taimecha/da_robot_kho_hang/memory-bank/progress.md

# Progress

## 2026-10-24 — rà soát điều phối ba xe

- Chạy mới `demo30` với ba Nav2, xe động học giả, camera/LiDAR tổng hợp và hàng
  chờ cột: 30/30 kiện, 0 lỗi audit, khoảng cách tâm nhỏ nhất 0,589657 m;
  kiện cuối 715,751 s, cả ba đỗ xong 736,402 s.
- Kiểm tra độc lập 9.600 trường hợp lưới trống: đường ngắn nhất và ít lần đổi
  hướng nhất trong các đường ngắn. Toàn bộ 164 test đạt. Báo cáo và log ở
  `docs/warehouse_route_audit_20261024/`.
- `tools/warehouse_report.py` ghi thêm quãng đường và tổng góc xoay odometry.
  Chưa khẳng định tối ưu toàn cục khi xe tranh chấp, hoặc kết quả xe thật.

## Đã xong (mới nhất trước)
| Ngày | Việc | Commit |
|---|---|---|
| 2026-10-16 | RViz hai xe: sửa xacro và launch để AGV1 thân/bánh xanh, AGV2 thân/bánh cam, trùng màu marker, footprint và hạt AMCL; chỉ đổi màu hiển thị, có hiệu lực khi khởi động lại robot_state_publisher | commit này |
| 2026-10-16 | Chuẩn bị 6 video NCKH liên tiếp: đặt xe và định vị một lần, điều hướng tự chuyển sang vị trí đầu từng clip, terminal lệnh và bag riêng cho mỗi clip trong `docs/KICH_BAN_VIDEO_NCKH.md`; đã dọn ROS/điều phối cũ khi xe tắt điện. Giao diện đo báo giao hàng thành công từng xe, giữ 10 giây và phát `delivered` | commit này |
| 2026-10-16 | Hai xe thật: lọc nhiễu LiDAR, hiệu chuẩn lại hai camera, chốt trung bình 5 ảnh; hộp xanh 23,9 cm vào ô (1,1) với nút xanh; xe 1 đạt góc 0,39° và lệch tâm 1,7 cm; điều phối `--no-stdin`, giao diện tự đóng sau khi cả hai xe giao xong. 39 unit tests đạt | HEAD |
| 2026-10-15 | **Đo hàng thật đạt, 2 xe trọn vòng**: GrabCut gieo từ LiDAR, camera yaw/pitch (`tools/cam_extrinsic.py --height`), cao tính tới sàn, giao lại khi bị chặn, firmware tự restart khi tạo entity lỗi; 18,5×32,0→18,7×32,0, 12,0×23,9→13,0×24,1 | 33c4443 |
| 2026-10-14 | ESP32-CAM dùng firmware stream sẵn (`cameras.agvN.url`), ảnh khác cỡ hiệu chuẩn → phóng lên; **sửa DDS**: WSL rơi gói UDP > 1472 B trên loopback → `tools/fastdds_localhost.xml` (gói 1400) | (HEAD) |
| 2026-10-13 | **Camera thật (code)**: `firmware/esp32_cam`, `tools/esp32_cam_node.py`, `tools/cam_calib.py`, camera riêng từng xe; lấy hàng cột 5 (quay Đông) → trả hàng 1; `fleet_real.sh` bật camera. Chưa thử phần cứng | (HEAD) |
| 2026-10-12 | **Đo hàng bằng camera (mô phỏng)**: `cargo_measure.py`, `cargo_task.py`, `tools/sim_cargo.py`, `cargo.yaml`; 9 lần đo sai ≤ 3,5 mm, hai xe chung ô đích, hàng quá khổ báo lỗi | (HEAD) |
| 2026-10-10 | Local costmap hết ô "kẹt" (vật cản còn trên RViz dù LiDAR không thấy): ObstacleLayer + `observation_persistence 1.0` + `fleet_agent` xoá lớp vật cản mỗi 1 s (`clear_except`, giữ 0.5 m); `raytrace_max_range 10` | (HEAD) |
| 2026-10-10 | **Hai xe thật chạy đủ 6 bước** theo logic mô phỏng, không va. Sửa: dây động cơ riêng từng xe, firmware tách `Xe_1`/`Xe_2`, ESTOP báo ngay về máy tính, URDF base_footprint tại trục bánh, xe không xoay vòng khi đích là ô đang đứng / chạy nốt khi Nav2 dừng sớm, `tools/fleet_localize.py` (ICP), `tools/wheel_test.py` | 7b1c103..(HEAD) |
| 2026-10-10 | Hai xe thật: hiệu chỉnh riêng từng xe (`WHEEL_R_agvN`, `COAST_agvN`), `fastdds shm clean` khi up/down; Kịch bản 4 có 6 bước thử lần đầu — chạy đủ 6 bước trên 2 ESP32 giả: tới đích, không va (lệch hướng 6–9° do AMCL giả thô) | a4af8ee |
| 2026-10-10 | **Môi trường vận hành tự động**: `tools/agvctl` (up/down/status/errors/events/logs/goal/stop/localize/serial/fw), `tools/fleet_monitor.py` (/rosout + nhịp + diag + AMCL → `~/agv_logs`), firmware `/agvN/diag` + `estop_reset`, MCP `ros` (`.mcp.json`, uv), biên dịch firmware bằng arduino-cli của IDE từ WSL, `docs/AGVCTL.md`. Thử đủ vòng với ESP32 giả | a4af8ee |
| 2026-10-10 | **Hai xe thật**: micro-ROS gắn ID xe (`/agvN`), `tools/fleet_real.sh`, `fleet_real_robot.launch.py`, Nav2 gộp container, `ns_relay.py` cho chế độ 1 xe, `auto_initial_pose --ns`, `fleet_fake_robot --esp32` (ESP32 giả, LiDAR dò tường bản đồ), Kịch bản 4 trong tài liệu. **Mới thử bằng ESP32 giả**, chưa chạy trên 2 xe thật | 1e5dec8 |
| 2026-10-10 | Local costmap luôn phát bản đầy đủ 5 Hz (nút đỏ không xoá khi xe đứng yên) | bffb85c |
| 2026-10-10 | Xe 2 không nhận lệnh: dây động cơ L/R nối chéo trên mạch mới → đổi nhóm chân trong `XE 2` | d0a9406 |
| 2026-10-10 | `#define XE`: xe 1 giữ nguyên, xe 2 mạch mới + LiDAR ×1.062 | da5d42a, 1bc41d0 |
| 2026-10-10 | RViz/Gazebo vẽ bằng GPU (`GALLIUM_DRIVER=d3d12`); sửa shader RViz; ẩn COPY MODE | 601b5b0, 6a3a454 |
| 2026-10-06 | Gazebo trong mô phỏng 2 xe: xem 3D + kéo trụ đỏ làm vật cản | 1c9a36e, 901833d |
| 2026-10-06 | Sketch test BNO055 qua Wi-Fi TCP 2323 | b8a511c, 23c4eea |
| 2026-10-06 | Tài liệu viết lại theo kịch bản; tách `SA_BAN_VA_TAI_LIEU.md` | ee1827e, 2ff7f0c |
| 2026-10-05 | Điều phối 2 xe (mô phỏng): giữ chỗ, ưu tiên gần đích, gỡ kẹt; firmware chân mạch in 2026-10-05 | 679f763, c3256a7 |
| trước đó | 1 xe thật trên sa bàn: xoay tại chỗ bằng gyro + coast, PID Kf 3.0, goal 2 cm; đẩy GitHub "1 Xe" | da0278b |

GitHub: đợt cập nhật này được đẩy lên `origin/main` theo yêu cầu ngày 2026-10-16; các lần sau chỉ đẩy khi người dùng bảo.

## Số đo
- **Xe 1 thật (2026-10-03):** 9/9 lần xoay ≤ 2.8° trong 4–6 s; tới đích lệch 0.4–1.6 cm;
  lệch cạnh khi chạy ≤ 0.6 cm trung bình (theo AMCL). LiDAR lệch tâm quay ~1.1 cm.
- **Xe 2 thật (2026-10-10):** LiDAR góc đúng (1.1°), khoảng cách thiếu 6.2% → bù 1.062, sau
  bù khớp 1.0014. Thử kê bánh tiến/lùi/trái/phải đều đúng chiều sau khi đổi chân động cơ.
  Xoay quanh 90° đo ω max 56°/s. **Chưa** chạy trọn sa bàn trên sàn.
- **Mô phỏng 2 xe (2026-10-10, sau khi gộp container):** swap, cross, headon, parked, prio,
  follow đều đạt; khoảng cách tâm–tâm nhỏ nhất ≥ 57 cm; tới đích lệch ≤ 2.1 cm. (Cross từng
  hỏng một lần vì lập đường lần đầu không thử lại → đã sửa.)
- **2 xe "thật" với ESP32 giả (domain 89):** đổi chỗ agv1 (3,1)↔agv2 (3,5) đạt, lệch đích
  2.9–3.4 cm (AMCL), hướng ≤ 3.4°; 18 tiến trình ROS; mỗi agent ~9% CPU.

## Vấn đề còn mở
- Cổng bộ nhớ chung FastDDS bị `kill -9` bỏ lại (/dev/shm) → container Nav2 bật sau không ai dò thấy; đã thêm `fastdds shm clean` vào fleet_real.sh. Nếu gặp lại ở chỗ khác: chạy lệnh đó khi hệ tắt.
- rosbridge chưa cài (cần sudo) → MCP `ros` chưa dùng được; `agvctl` vẫn đủ để đọc lỗi.
- Mô phỏng ESP32 giả: sau khi tới đích, agv2 báo hướng Nam +7.8° theo AMCL dù agent báo xoay
  xong −0.5° (AMCL chỉnh lại sau khi dừng?) — cần xem lại trên xe thật.
- Nav2 agv2 đôi khi không lên lần 1: `failed to send response to .../load_node (timeout)`
  (fleet_real.sh tự thử lại, lần 2 lên).
- **Chạy 2 xe thật lần đầu** (Kịch bản 4) — đang chờ người dùng nạp firmware có namespace
  cho cả 2 xe.
- Xe 2: `wheel_radius` (0.03281) và `coast` (0.36) đang dùng số đo của xe 1 → có thể cần đo
  lại riêng (`tools/check_odom_scale.py`, phân tích xoay).
- Xe trôi song song vạch dù RViz báo bám (nghi sai lệch tịnh tiến lưới ↔ băng keo) — cần
  người dùng đo bằng thước; chưa có số.
- `firmware/encoder_test` còn chân cũ.
- Nút (1,5) bị bỏ vì sát vật cản trên bản đồ (14 cm < 25 cm).
- Mạch in xe 2: J2_1 (3V3 cho encoder/BNO055) từng chưa nối — đã hỏi, chưa xác nhận.

## Lỗi đã sửa — đừng lặp lại
- `pgrep -f "micro_ros_agent udp4"` khớp cả shell khác có chuỗi đó → `pgrep -x micro_ros_agent`.
- Đọc Serial bằng `ReadLine` không ra gì khi firmware in dấu chấm không xuống dòng → `ReadExisting`.
- Pending model xoay tại chỗ (tính cả lệnh xe không nhúc nhích) → dùng gyro + coast.
- `/odom` ω có gai → điều khiển xoay theo gyro (`rot_w()`).
- Goal checker dừng ở 2.6–2.9 cm → `xy_goal_tolerance 0.02`.
- `navigation_launch.py` không đẩy namespace → `fleet_nav.launch.py` dùng `PushROSNamespace`.
- Costmap đa xe nghe `/agvN/local_costmap/scan` → topic tuyệt đối từng xe.
- LiDAR giả không tường → bóng ma không xoá → `inf_is_valid` (chỉ mô phỏng).
- `route_id` trùng giữa các lần chạy traffic_manager → id theo thời gian.
- Agent trùng tên chạy song song giành goal → `fleet_sim.sh down` pkill theo mẫu.
- Nav2 2 xe bật song song mất trả lời lifecycle → bật tuần tự + thử lại.
- `MultiThreadedExecutor` ăn CPU; DDS LOCALHOST giới hạn tiến trình; container thiếu file
  tham số → xem techContext "Bẫy".
