taimecha/da_robot_kho_hang/docs/THU_40RPM_AGV1_2026-10-18.md

# Thử đáp ứng 40 RPM trên AGV1 — 18/10/2026

Xe 1 chạy thẳng trên sàn với lệnh **40,0 RPM mỗi bánh** (quy đổi từ 0,135088 m/s, vận tốc góc 0) trong 3 s, sau đó gửi lệnh dừng. Người vận hành báo điện áp pin **11,5 V** trước thử; đây không phải điện áp đo trong lúc động cơ chịu tải. Firmware dùng Kp = 1,20, Ki = 0,08, Kd = 0,01 và Kf = 3,0. Dữ liệu RPM lấy từ encoder sau lọc trong ESP32 (~50 Hz); PWM lấy từ gói chẩn đoán (~1 Hz). Không dùng Nav2.

- [Đồ thị PNG](figures/pid_real_agv1/agv1_pid_20261018_195832.png) và [PDF](figures/pid_real_agv1/agv1_pid_20261018_195832.pdf).
- [Dữ liệu encoder](figures/pid_real_agv1/agv1_pid_20261018_195832_joint.csv), [dữ liệu PWM](figures/pid_real_agv1/agv1_pid_20261018_195832_diag.csv), [tóm tắt JSON](figures/pid_real_agv1/agv1_pid_20261018_195832_summary.json).

| Chỉ tiêu | Kết quả |
|---|---:|
| Dải xác lập ±5% của 40 RPM | 38–42 RPM |
| RPM trung bình hai bánh tại mốc 0,5 s | 25,8 RPM |
| Thời gian hai bánh cùng ở trong dải ±5% và duy trì tới lúc dừng | ~2,14 s |
| Thời gian RPM trung bình hai bánh xác lập ±5% | 2,12 s |
| RPM trung bình hai bánh trong 2 s cuối | 37,36 RPM |
| RPM trung bình hai bánh ở 0,5 s cuối | ~39,3 RPM |
| PWM khi đang chạy, mẫu khoảng 1/2/3 s | 218/228/231 trên 255 |
| Quãng đường suy từ encoder | 0,372 m |

**Kết luận theo phép thử:** Với cấu hình điều khiển và nguồn pin nêu trên, yêu cầu xác lập ±5% trong 0,5 s **chưa đạt**. Tại mốc 0,5 s, xe mới ở khoảng 65% tốc độ đặt. PWM về gần 231/255 ở cuối phép thử, nhưng dữ liệu 1 Hz không cho biết chính xác PWM trong 0,5 s đầu. Không thể từ một lần thử này kết luận riêng động cơ JGA25-370 không bao giờ đạt 0,5 s; cần đo điện áp ngay tại cực động cơ dưới tải và thử đáp ứng với lệnh PWM tối đa có giới hạn an toàn để xác định giới hạn vật lý của tổ hợp pin, L298N, động cơ và tải.

**Chú thích hình đề xuất:** “Đáp ứng tốc độ bánh trái, bánh phải và RPM trung bình hai bánh của AGV1 trước lệnh 40 RPM trên sàn. Vùng xanh nhạt biểu thị dải xác lập 38–42 RPM (±5%). Xe vào dải sau khoảng 2,12 s, chưa đạt mục tiêu 0,5 s. Các điểm PWM lấy mẫu khoảng 1 Hz.”

## Tinh chỉnh tiếp theo trên giá kê

Sau phép thử trên sàn ở trên, nhóm tăng phản hồi và hiệu chỉnh dự đoán PWM của **riêng AGV1**. Cấu hình đang nạp là **Kf = 4,75; Kp = 3,00; Ki = 0,16; Kd = 4,00**, với giới hạn PWM 255, bù ma sát khởi động 40 và giới hạn tăng tốc đặt 320 RPM/s. Xe 2 giữ nguyên cấu hình cũ. Hai bánh AGV1 được kê hở sàn để kiểm tra đáp ứng trước khi cho xe chạy trên sàn.

| Lần thử 40 RPM trên giá kê | 1 | 2 |
|---|---:|---:|
| Thời gian cả hai bánh xác lập trong ±5% | 0,39 s | 0,38 s |
| RPM đỉnh bánh trái | 42,05 | 42,28 |
| RPM đỉnh bánh phải | 42,25 | 42,39 |
| RPM trung bình hai bánh trong 2 s cuối | 39,62 | 39,60 |

[Hình lần 1](figures/pid_real_agv1/agv1_pid_20261018_201057.png) · [Hình lần 2](figures/pid_real_agv1/agv1_pid_20261018_201115.png) · [Dữ liệu lần 1](figures/pid_real_agv1/agv1_pid_20261018_201057_joint.csv) · [Dữ liệu lần 2](figures/pid_real_agv1/agv1_pid_20261018_201115_joint.csv).

Hai lần trên giá kê đều đạt tiêu chí thời gian dưới 0,5 s, nhưng có vọt lố thoáng qua khoảng 5–6%. Kết quả này được dùng để kiểm tra trước khi chạy trên sàn, không thay thế phép thử chịu tải.

## Kiểm tra cấu hình cuối khi chạy trên sàn

Người vận hành đặt lại AGV1 ở đầu đoạn trống; xe chạy thẳng không chở hàng với cùng mức đặt 40 RPM trong 3 s. Đây là **một lần chạy** với cấu hình cuối, không phải phép đánh giá độ lặp lại. Sau thử, ESP32 báo cả hai bánh 0 RPM, mức đặt 0 và không có ESTOP.

| Chỉ tiêu | Cấu hình trước | Cấu hình cuối |
|---|---:|---:|
| Thời gian cả hai bánh xác lập trong ±5% trên sàn | 2,14 s | **0,245 s** |
| RPM lớn nhất bánh trái | 39,70 | 41,61 |
| RPM lớn nhất bánh phải | 39,77 | 41,45 |
| RPM trung bình hai bánh trong 2 s cuối | 37,36 | 39,65 |
| Sai lệch trung bình hai bánh trong 2 s cuối | −6,60% | −0,87% |
| Quãng đường suy từ encoder | 0,372 m | 0,427 m |

[Đồ thị cấu hình cuối trên sàn](figures/pid_real_agv1/agv1_pid_20261018_201426.png) · [PDF](figures/pid_real_agv1/agv1_pid_20261018_201426.pdf) · [Dữ liệu encoder](figures/pid_real_agv1/agv1_pid_20261018_201426_joint.csv) · [PWM](figures/pid_real_agv1/agv1_pid_20261018_201426_diag.csv) · [Tóm tắt JSON](figures/pid_real_agv1/agv1_pid_20261018_201426_summary.json).

**Kết luận giới hạn:** Trong lần thử này, AGV1 đạt yêu cầu xác lập tốc độ bánh ±5% dưới 0,5 s ở mức đặt 40 RPM và nguồn pin người vận hành báo còn 11,5 V khi động cơ chạy. RPM được tính từ encoder đã lọc trong firmware, không phải tốc độ đo bằng thiết bị độc lập. Quãng đường cũng chỉ suy từ encoder; chưa đo lại bằng thước. Cần lặp thêm ở các mức pin/tải khác nếu muốn khẳng định kết quả áp dụng cho toàn bộ điều kiện vận hành.

**Đoạn có thể đưa vào báo cáo:** “Sau khi hiệu chỉnh bộ điều khiển tốc độ của AGV1, nhóm thử nghiệm xe chạy thẳng không tải trên sàn với mức đặt 40 vòng/phút cho mỗi bánh trong 3 s. Cả hai bánh cùng vào dải sai lệch ±5% sau 0,245 s và duy trì trong dải đến khi kết thúc lệnh. Tốc độ lớn nhất ghi nhận ở bánh trái và bánh phải lần lượt là 41,61 và 41,45 vòng/phút. Trong 2 s cuối, RPM trung bình hai bánh là 39,65 vòng/phút, thấp hơn mức đặt 0,87%. Kết quả từ một lần chạy cho thấy mục tiêu thời gian xác lập dưới 0,5 s đã đạt ở điều kiện thử này; cần lặp lại để đánh giá độ tin cậy.”
