taimecha/da_robot_kho_hang/data/sim_trial_01_20261026/figures/quy_dao_2_xe.png

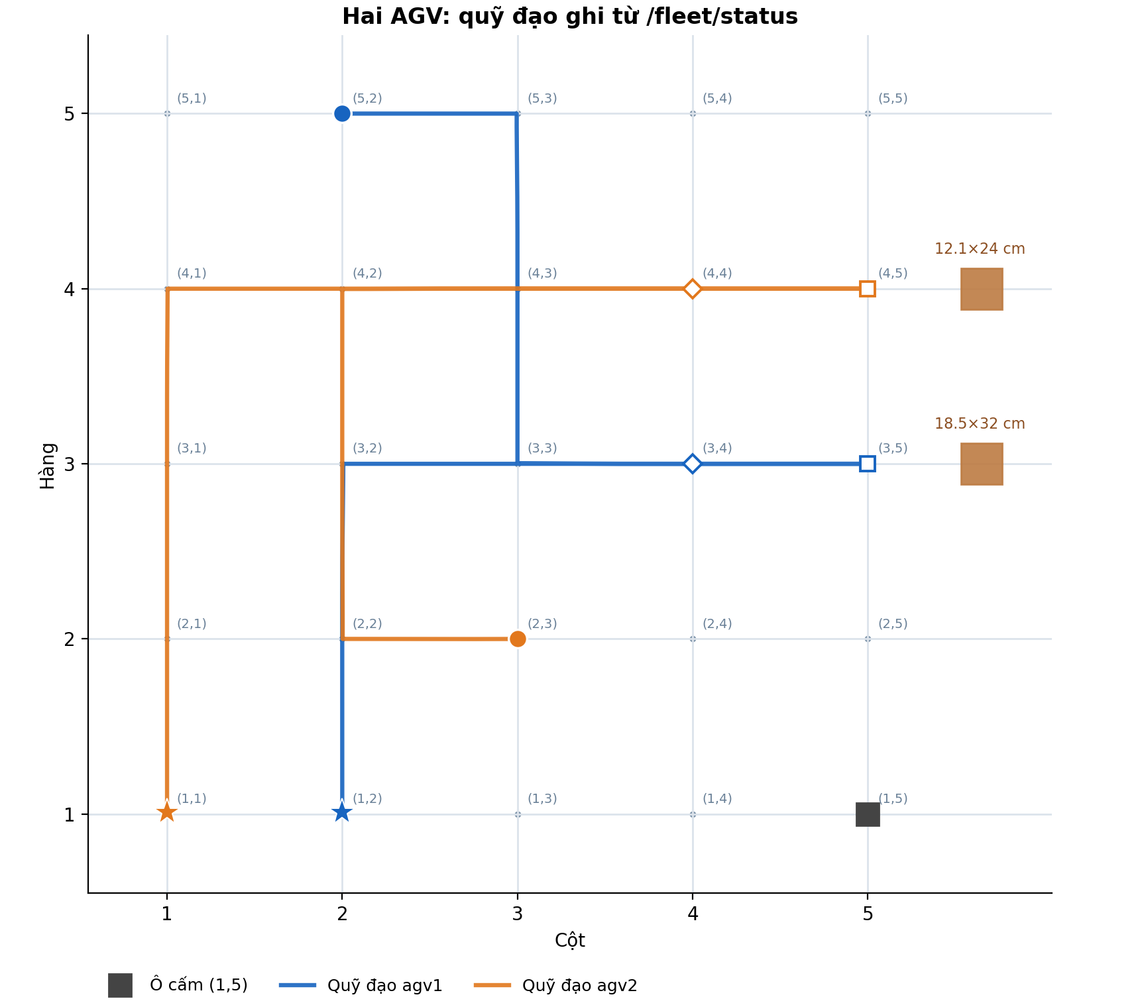
data/sim_trial_01_20261026/figures/quy_dao_2_xe.png
