taimecha/da_robot_kho_hang/data/sim_trial_01_20261026/figures/sai_so_do_hop_ao.png

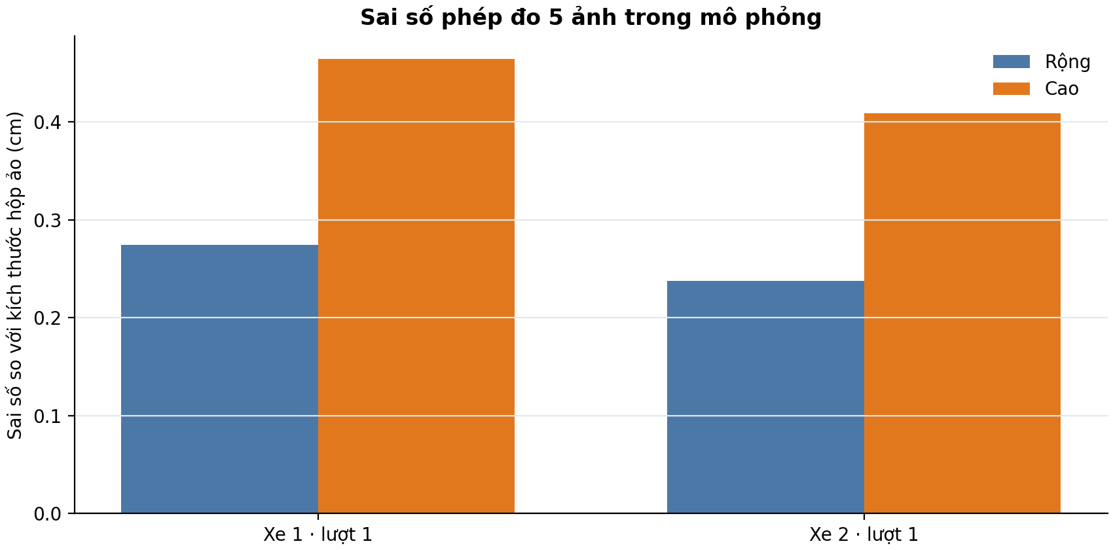
data/sim_trial_01_20261026/figures/sai_so_do_hop_ao.png
