taimecha/da_robot_kho_hang/data/sim_trial_01_20261026/figures/thoi_gian_lay_giao.png

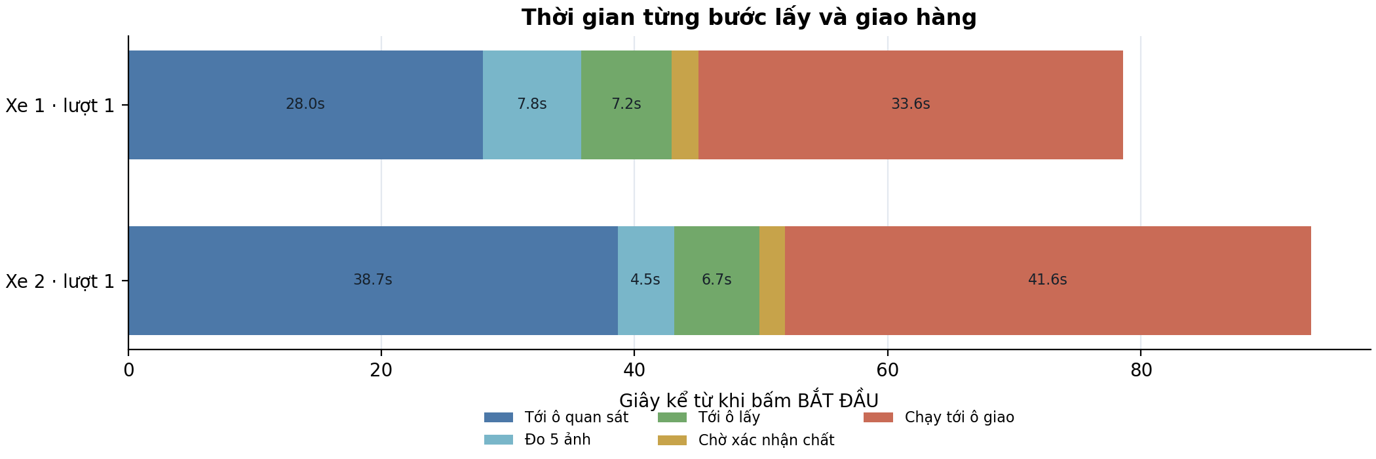
data/sim_trial_01_20261026/figures/thoi_gian_lay_giao.png
