taimecha/da_robot_kho_hang/data/sim_trial_01_20261026/images/00_before_start.png

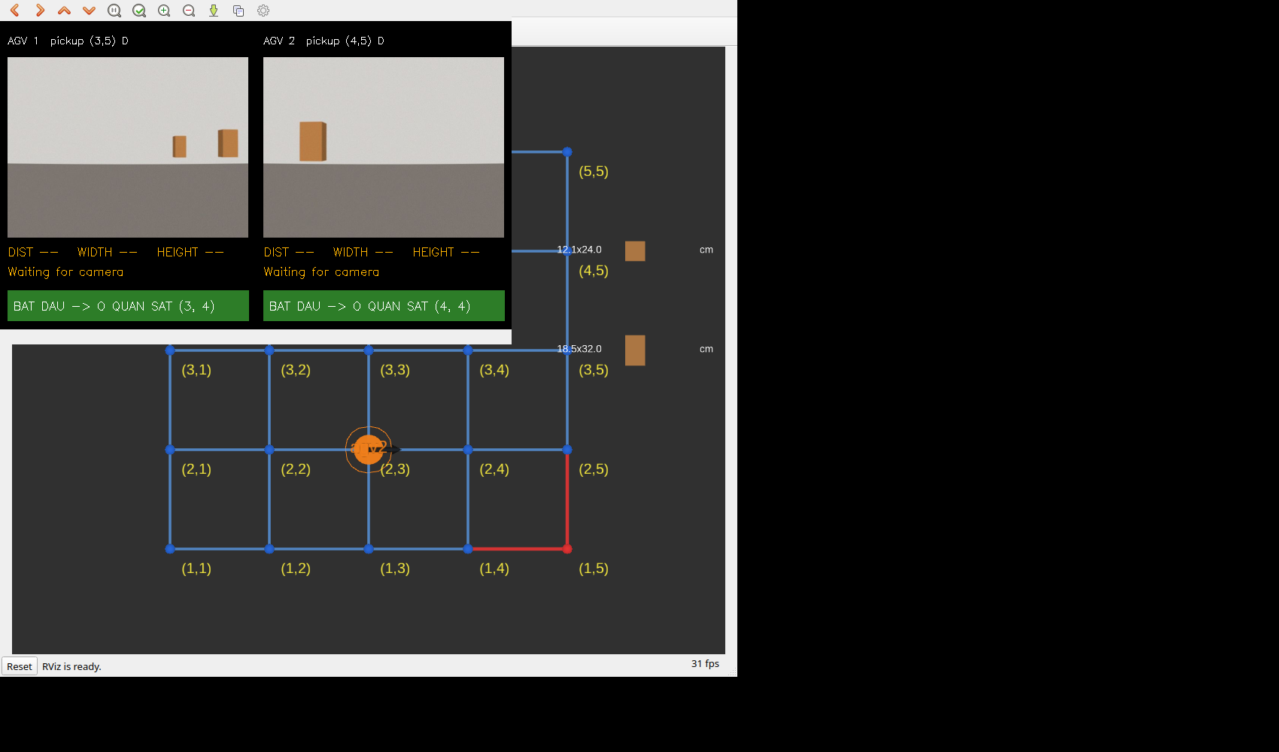
data/sim_trial_01_20261026/images/00_before_start.png
