taimecha/da_robot_kho_hang/data/sim_trial_01_20261026/images/01_running.png

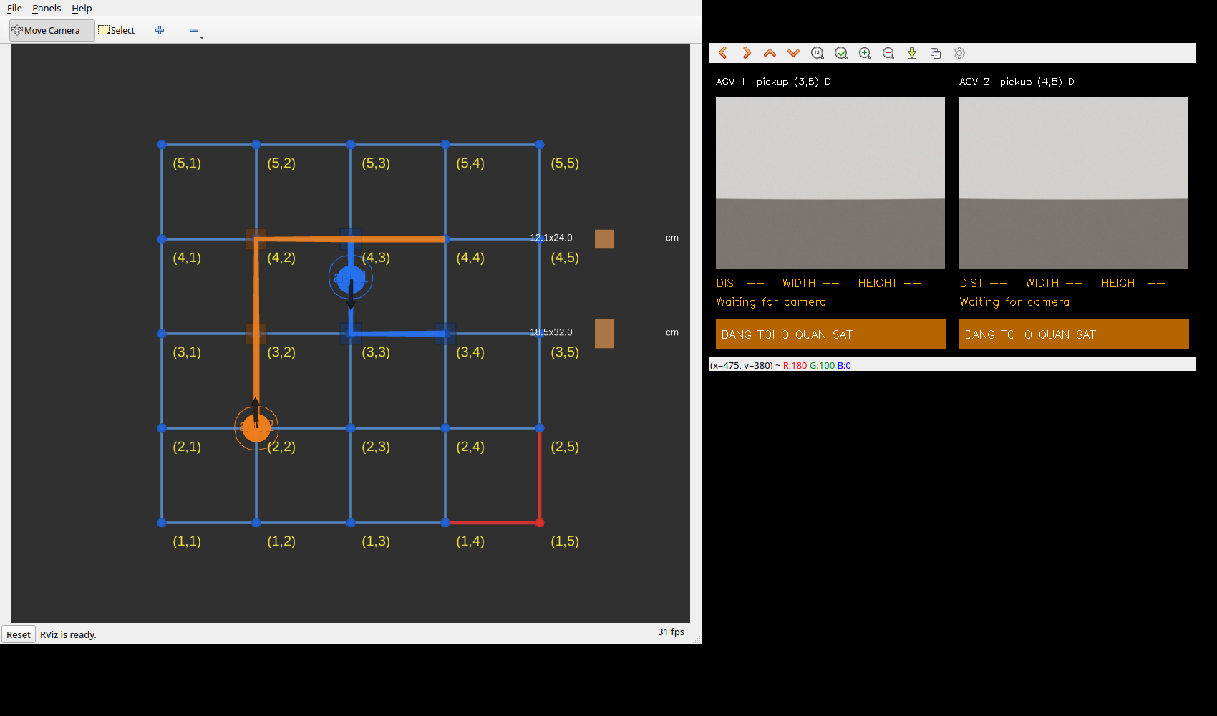
data/sim_trial_01_20261026/images/01_running.png
