taimecha/da_robot_kho_hang/data/sim_trial_01_20261026/images/02_both_delivered.png

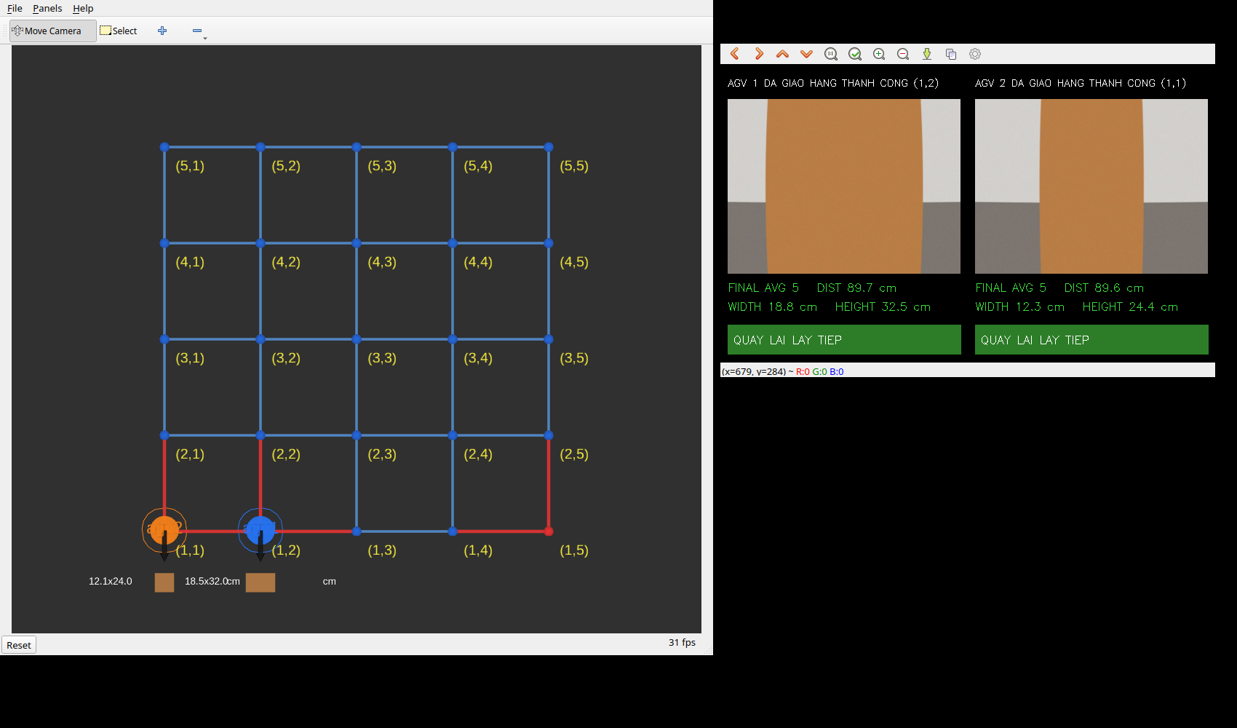
data/sim_trial_01_20261026/images/02_both_delivered.png
