taimecha/da_robot_kho_hang/data/sim_trial_01_20261026/images/stages/cycle1_agv2_loaded_confirmed.png

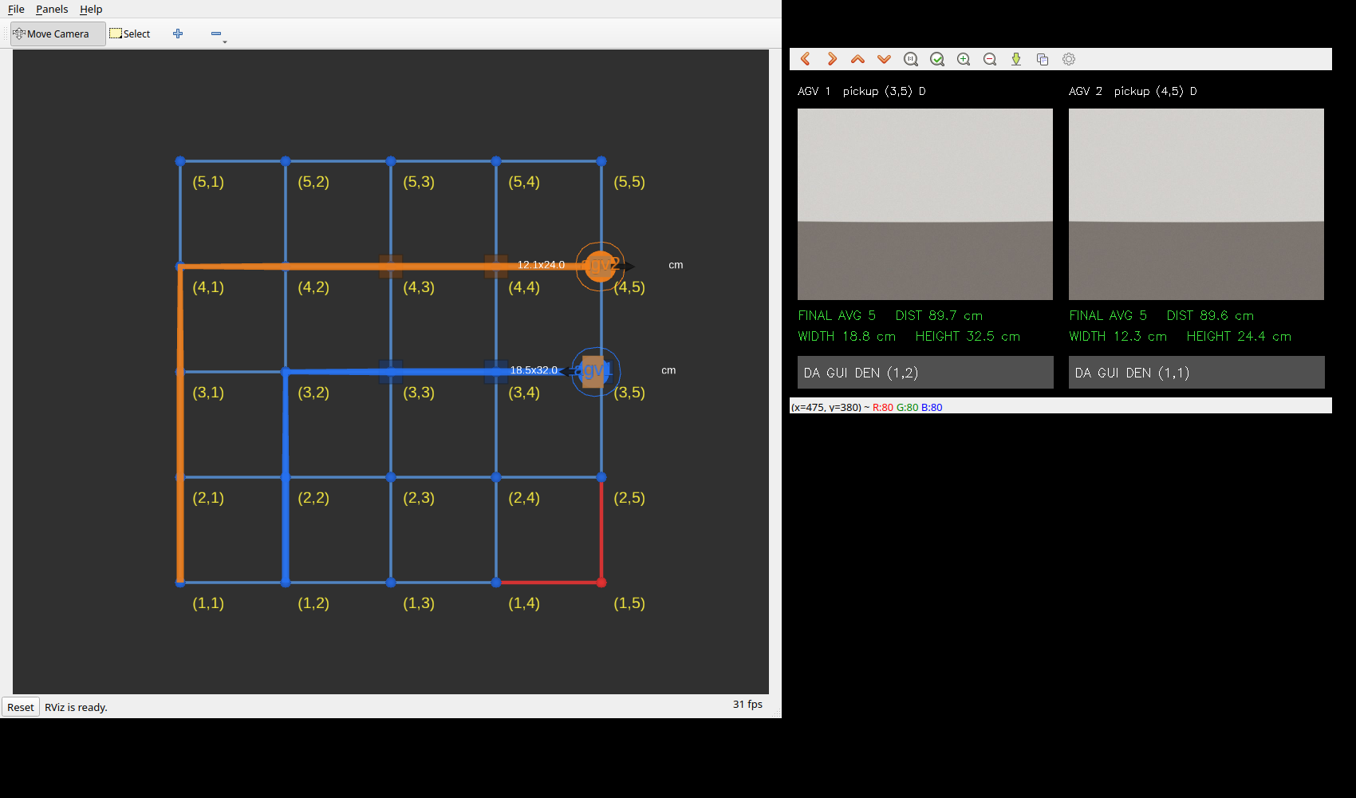
data/sim_trial_01_20261026/images/stages/cycle1_agv2_loaded_confirmed.png
