taimecha/da_robot_kho_hang/data/warehouse_demo_20261027_104104/dashboard_latest.jpg

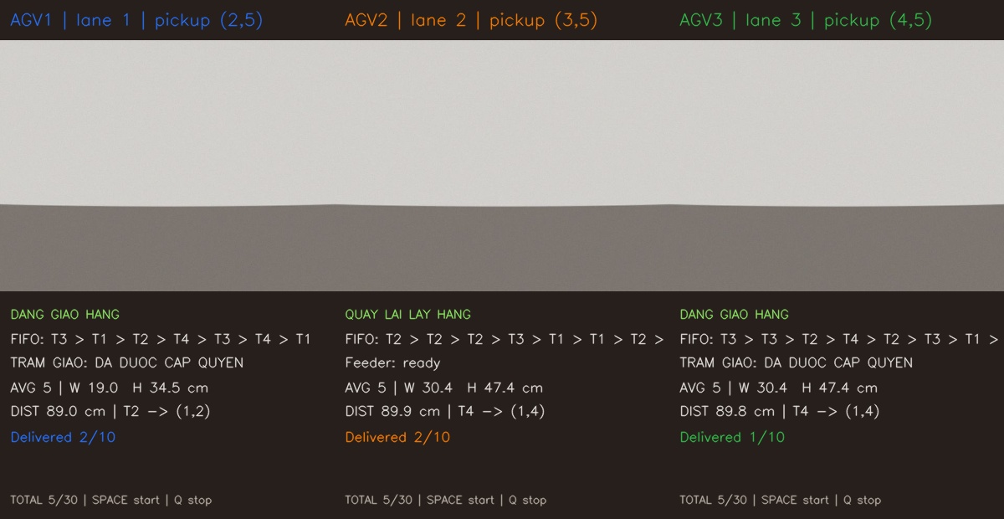
data/warehouse_demo_20261027_104104/dashboard_latest.jpg
