taimecha/da_robot_kho_hang/docs/figures/mo_phong_nckh/rviz_doi_cho.png

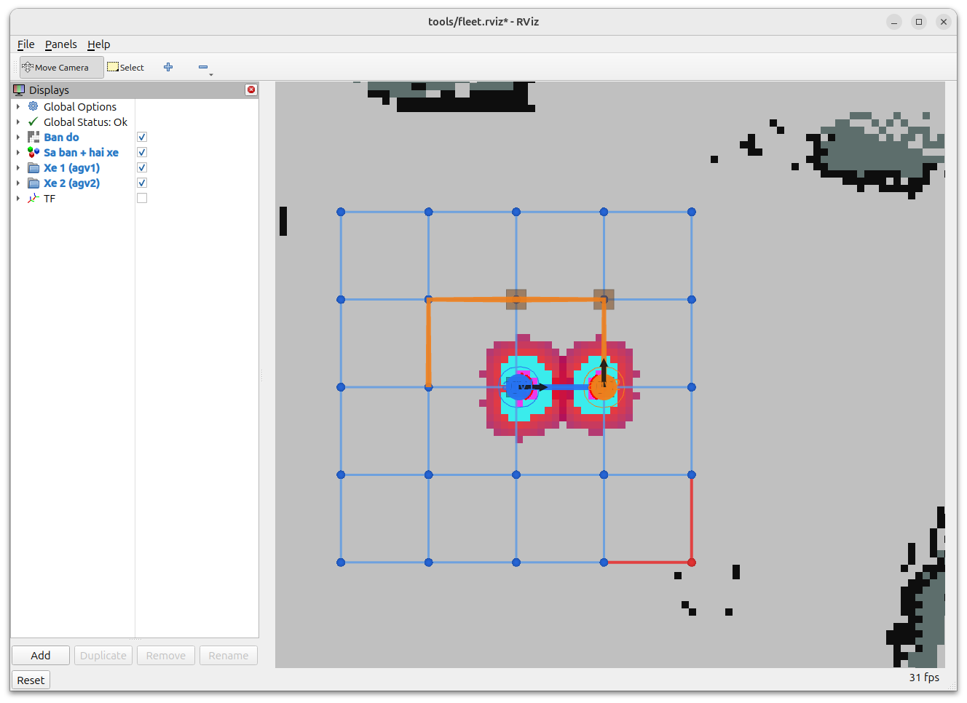
docs/figures/mo_phong_nckh/rviz_doi_cho.png
