taimecha/da_robot_kho_hang/docs/figures/mo_phong_nckh/rviz_giao_cat.png

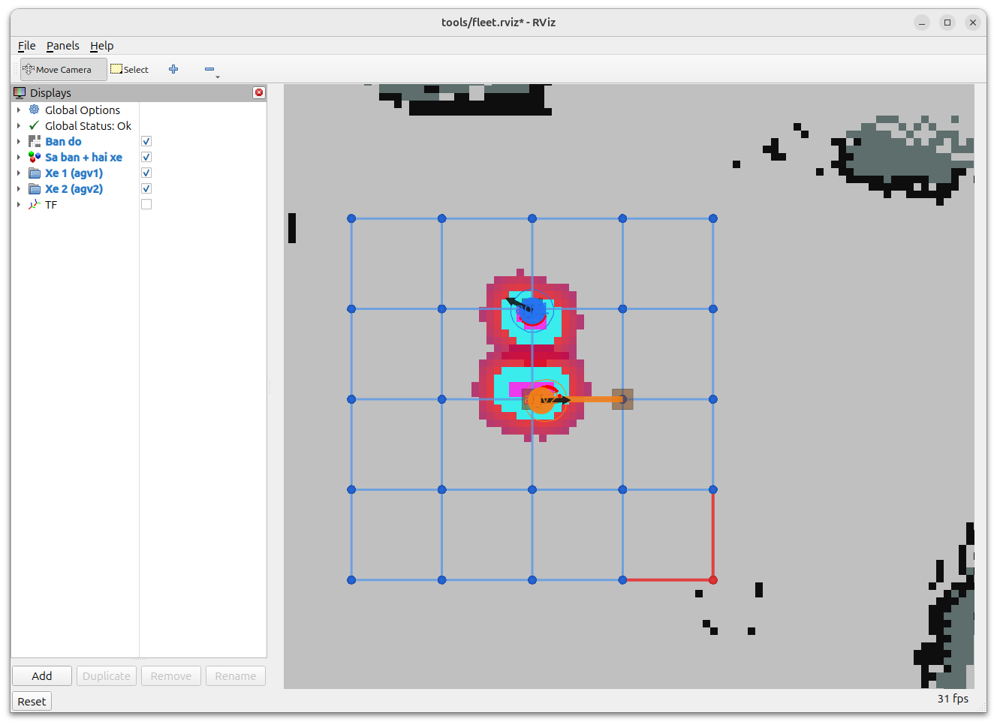
docs/figures/mo_phong_nckh/rviz_giao_cat.png
