taimecha/da_robot_kho_hang/docs/figures/pid_real_agv1/agv1_drive_2m_20261018_201712.png

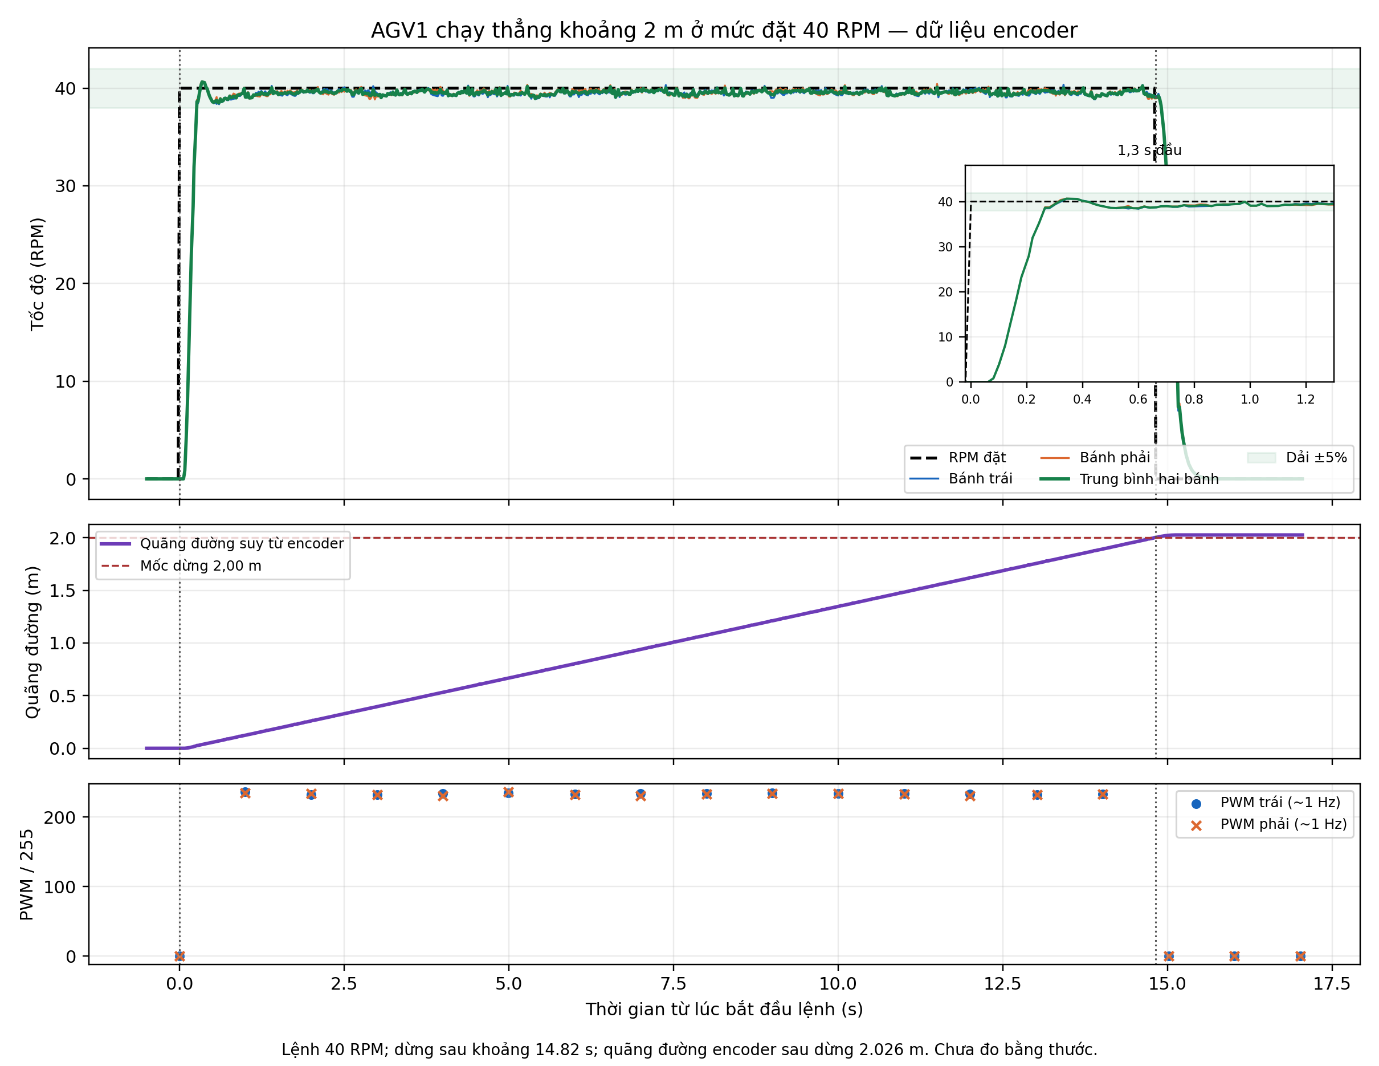
docs/figures/pid_real_agv1/agv1_drive_2m_20261018_201712.png
