taimecha/da_robot_kho_hang/docs/figures/pid_real_agv1/agv1_pid_40rpm_pid_new_stand.png

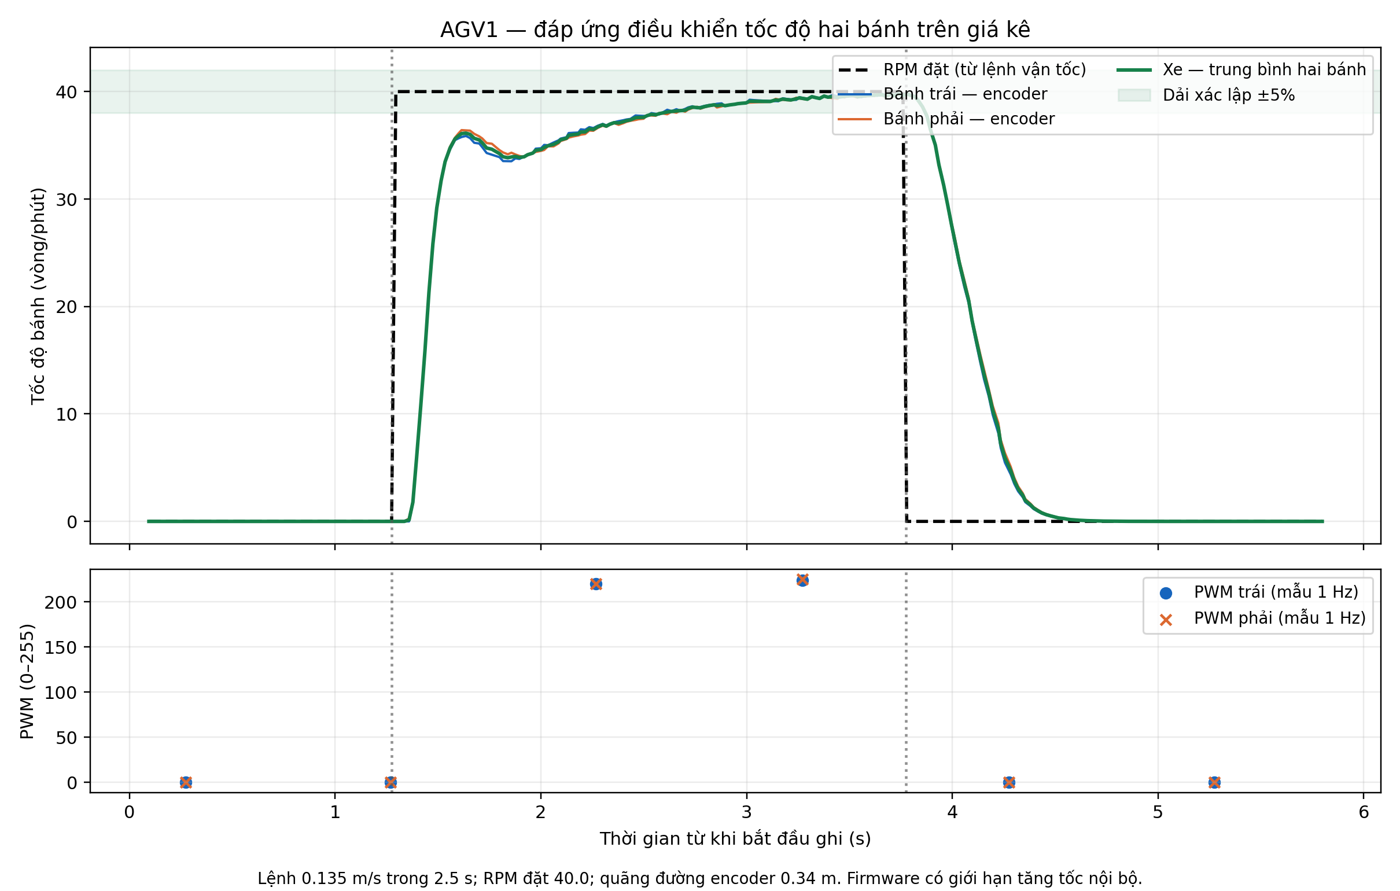
docs/figures/pid_real_agv1/agv1_pid_40rpm_pid_new_stand.png
