taimecha/da_robot_kho_hang/docs/figures/pid_real_agv1/agv1_pid_20261018_201426.png

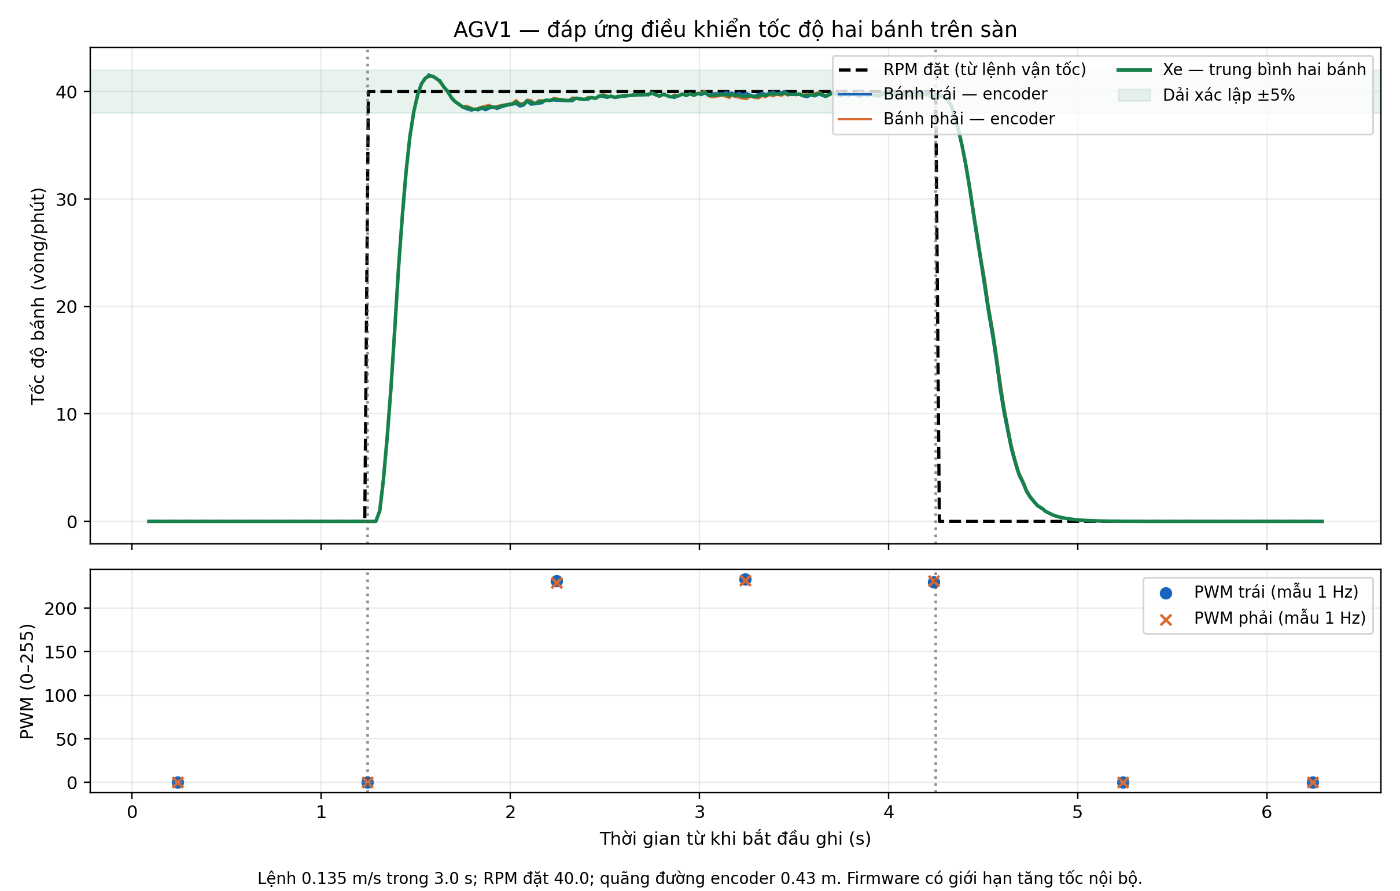
docs/figures/pid_real_agv1/agv1_pid_20261018_201426.png
