taimecha/da_robot_kho_hang/docs/minh_chung_video_6/video6_giao_dien_camera_nguon.png

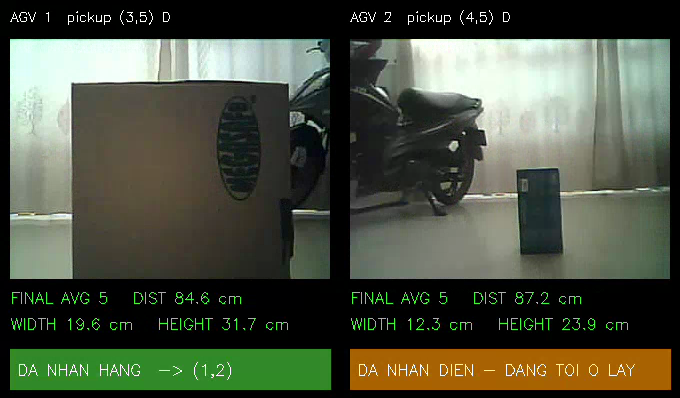
docs/minh_chung_video_6/video6_giao_dien_camera_nguon.png
