taimecha/da_robot_kho_hang/docs/minh_chung_video_6/video6_nhan_dien_hai_xe.png

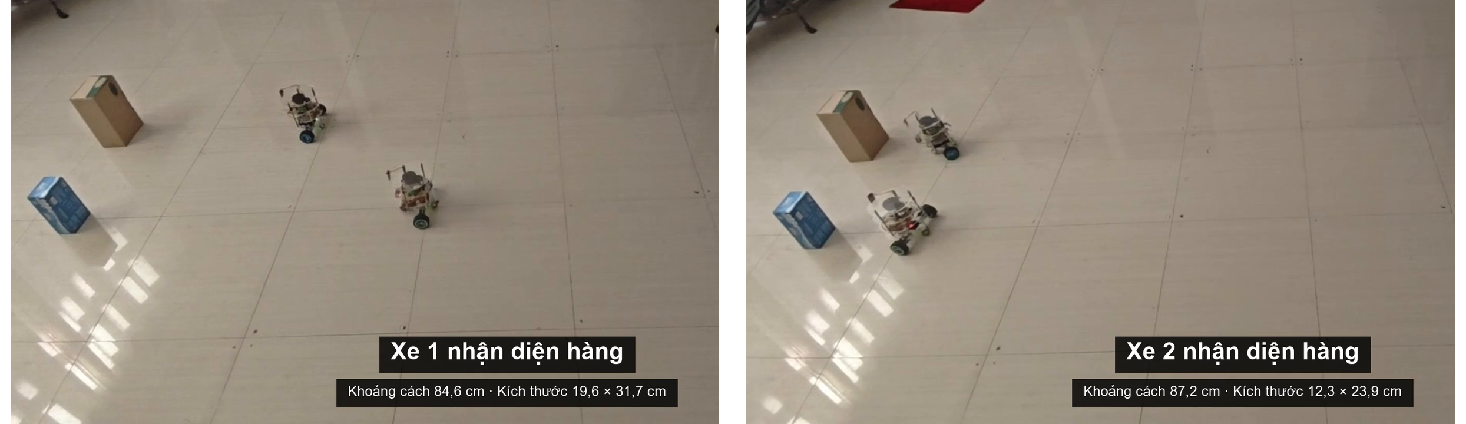
docs/minh_chung_video_6/video6_nhan_dien_hai_xe.png
