taimecha/da_robot_kho_hang/docs/nckh_2xe_sim_20261026/final/images/rviz_start.png

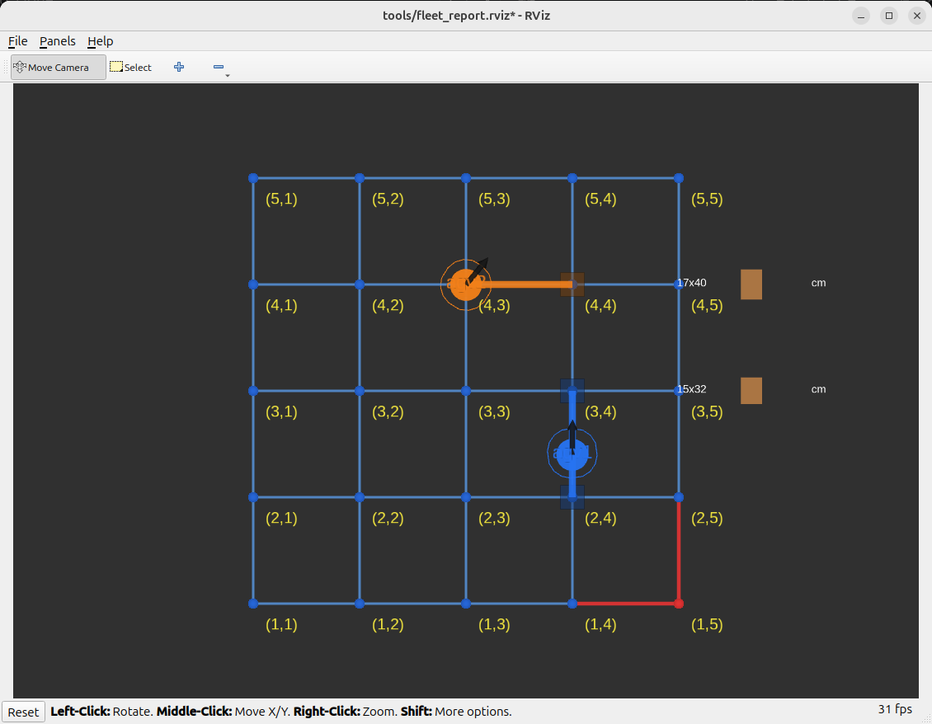
docs/nckh_2xe_sim_20261026/final/images/rviz_start.png
