taimecha/da_robot_kho_hang/docs/nckh_2xe_sim_20261026/images/cargo_pickup.png

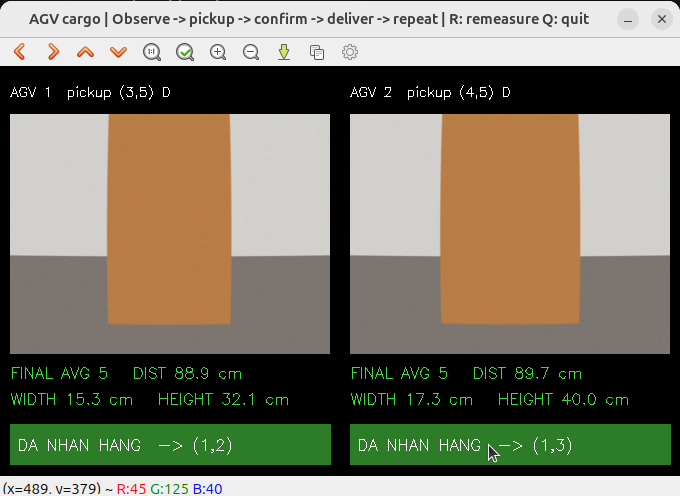
docs/nckh_2xe_sim_20261026/images/cargo_pickup.png
