taimecha/da_robot_kho_hang/docs/nckh_2xe_sim_20261026/images/desktop_check.png

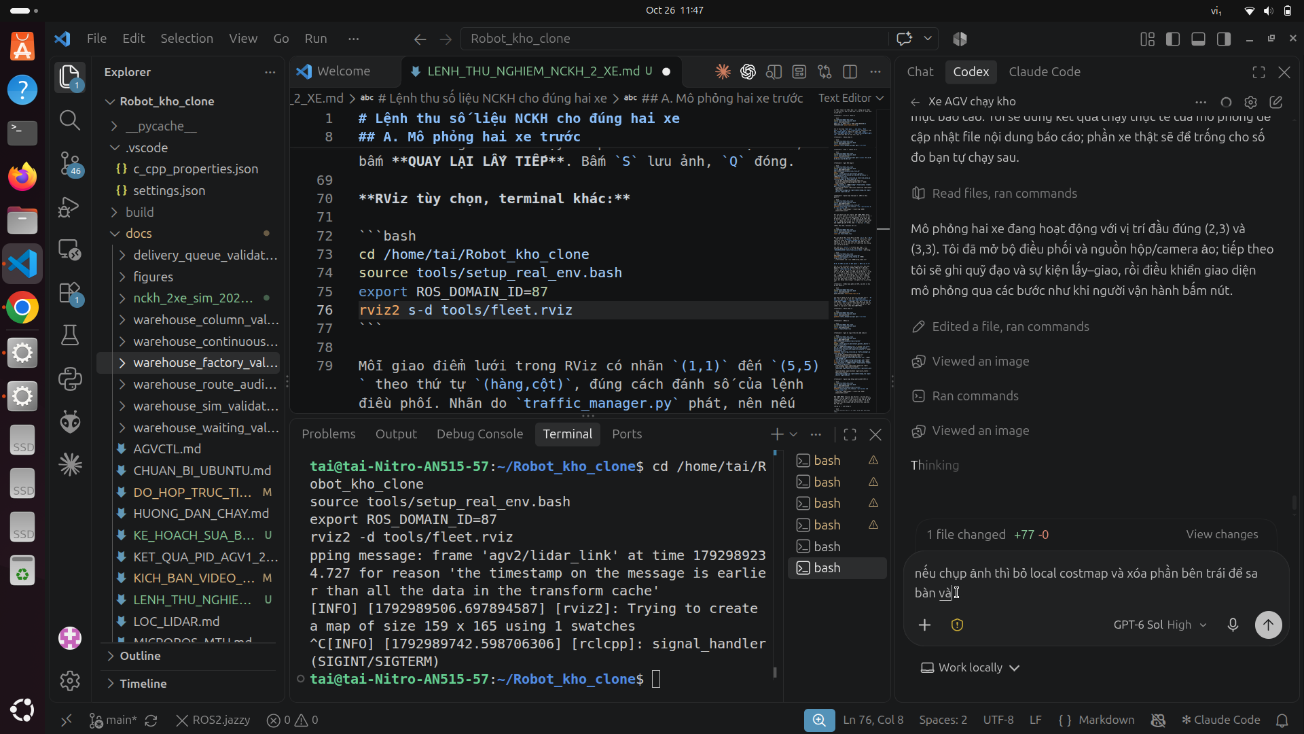
docs/nckh_2xe_sim_20261026/images/desktop_check.png
