taimecha/da_robot_kho_hang/docs/nckh_2xe_sim_20261026/images/rviz_delivery_route.png

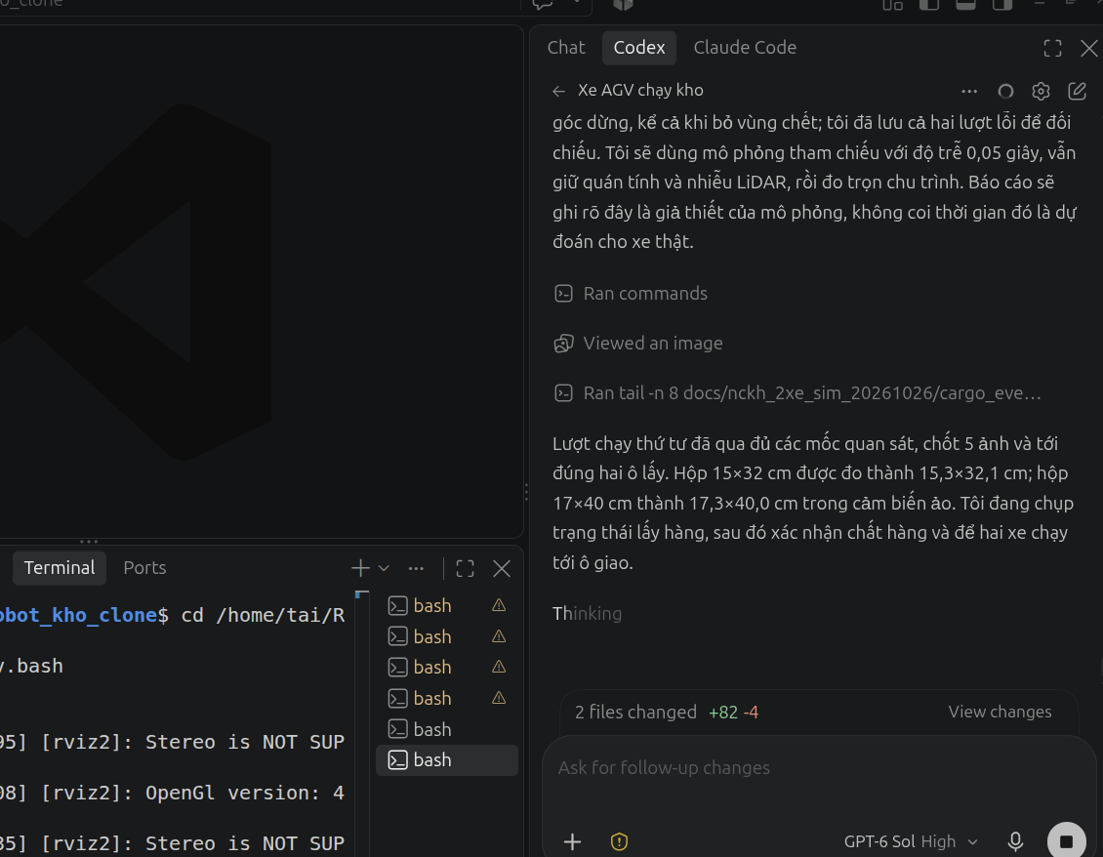
docs/nckh_2xe_sim_20261026/images/rviz_delivery_route.png
