taimecha/da_robot_kho_hang/docs/video_demo_2x/xem_truoc_video_6.jpg

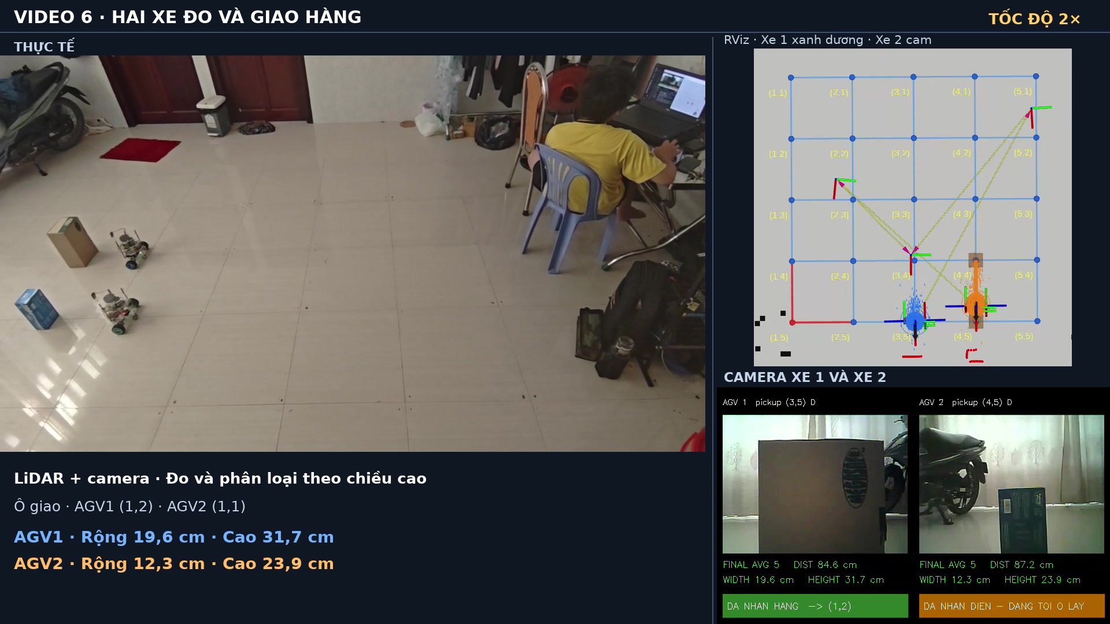
docs/video_demo_2x/xem_truoc_video_6.jpg
