taimecha/da_robot_kho_hang/docs/warehouse_route_audit_20261024/trajectories_and_deliveries.png

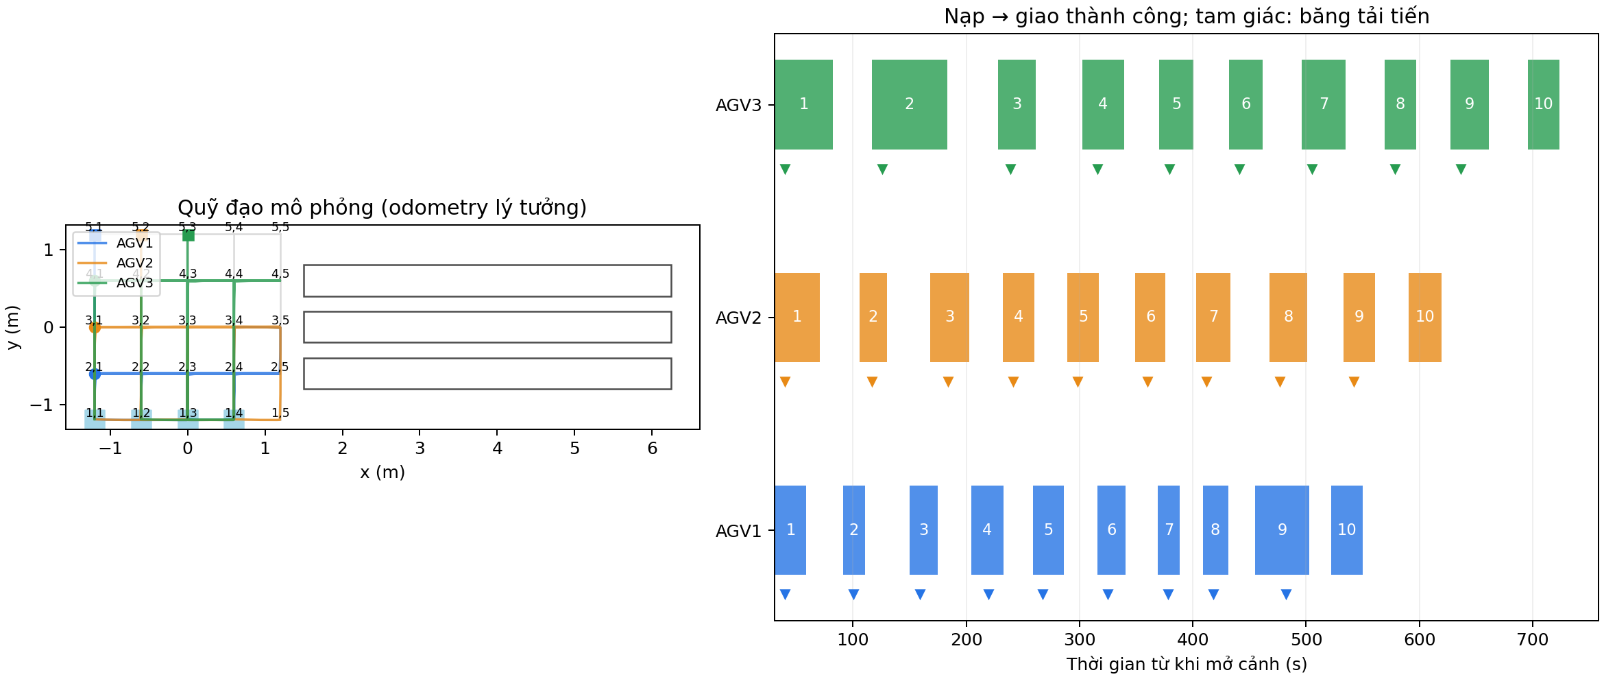
docs/warehouse_route_audit_20261024/trajectories_and_deliveries.png
