taimecha/da_robot_kho_hang/docs/delivery_queue_validation/serial_trajectories.csv

t_s | robot | x_m | y_m | yaw_rad | phase | payload
3.268 | agv3 | -1.2 | 0.6 | 0.0 | waiting
3.268 | agv1 | -1.2 | -0.6 | 0.0 | waiting
3.268 | agv2 | -1.2 | 0.0 | 0.0 | waiting
3.768 | agv3 | -1.2 | 0.6 | 0.0 | waiting
3.768 | agv1 | -1.2 | -0.6 | 0.0 | waiting
3.768 | agv2 | -1.2 | 0.0 | 0.0 | waiting
4.319 | agv3 | -1.2 | 0.6 | 0.0 | waiting
4.319 | agv1 | -1.2 | -0.6 | 0.0 | waiting
4.319 | agv2 | -1.2 | 0.0 | 0.0 | waiting
4.868 | agv3 | -1.2 | 0.6 | 0.0 | waiting
4.868 | agv1 | -1.2 | -0.6 | 0.0 | waiting
4.868 | agv2 | -1.2 | 0.0 | 0.0 | waiting
5.368 | agv3 | -1.2 | 0.6 | 0.0 | waiting
5.368 | agv1 | -1.2 | -0.6 | 0.0 | waiting
5.368 | agv2 | -1.2 | 0.0 | 0.0 | waiting
5.868 | agv3 | -1.2 | 0.6 | 0.0 | waiting
5.868 | agv1 | -1.2 | -0.6 | 0.0 | waiting
5.868 | agv2 | -1.2 | 0.0 | 0.0 | waiting
6.369 | agv3 | -1.2 | 0.6 | 0.0 | waiting
6.369 | agv1 | -1.2 | -0.6 | 0.0 | waiting
6.369 | agv2 | -1.2 | 0.0 | 0.0 | waiting
6.918 | agv3 | -1.2 | 0.6 | 0.0 | waiting
6.918 | agv1 | -1.2 | -0.6 | 0.0 | waiting
6.918 | agv2 | -1.2 | 0.0 | 0.0 | waiting
7.468 | agv3 | -1.2 | 0.6 | 0.0 | waiting
7.468 | agv1 | -1.2 | -0.6 | 0.0 | waiting
7.468 | agv2 | -1.2 | 0.0 | 0.0 | waiting
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
