taimecha/da_robot_kho_hang/docs/delivery_queue_validation/staged_trajectories.csv

t_s | robot | x_m | y_m | yaw_rad | phase | payload
0.094 | agv1 | -1.2 | -0.6 | 0.0 | waiting
0.094 | agv2 | -1.2 | 0.0 | 0.0 | waiting
0.094 | agv3 | -1.2 | 0.6 | 0.0 | waiting
0.644 | agv1 | -1.2 | -0.6 | 0.0 | waiting
0.644 | agv2 | -1.2 | 0.0 | 0.0 | waiting
0.644 | agv3 | -1.2 | 0.6 | 0.0 | waiting
1.194 | agv1 | -1.2 | -0.6 | 0.0 | waiting
1.194 | agv2 | -1.2 | 0.0 | 0.0 | waiting
1.194 | agv3 | -1.2 | 0.6 | 0.0 | waiting
1.694 | agv1 | -1.2 | -0.6 | 0.0 | waiting
1.694 | agv2 | -1.2 | 0.0 | 0.0 | waiting
1.694 | agv3 | -1.2 | 0.6 | 0.0 | waiting
2.194 | agv1 | -1.2 | -0.6 | 0.0 | waiting
2.194 | agv2 | -1.2 | 0.0 | 0.0 | waiting
2.194 | agv3 | -1.2 | 0.6 | 0.0 | waiting
2.744 | agv1 | -1.2 | -0.6 | 0.0 | waiting
2.744 | agv2 | -1.2 | 0.0 | 0.0 | waiting
2.744 | agv3 | -1.2 | 0.6 | 0.0 | waiting
3.294 | agv1 | -1.2 | -0.6 | 0.0 | waiting
3.294 | agv2 | -1.2 | 0.0 | 0.0 | waiting
3.294 | agv3 | -1.2 | 0.6 | 0.0 | waiting
3.794 | agv1 | -1.2 | -0.6 | 0.0 | waiting
3.794 | agv2 | -1.2 | 0.0 | 0.0 | waiting
3.794 | agv3 | -1.2 | 0.6 | 0.0 | waiting
4.294 | agv1 | -1.2 | -0.6 | 0.0 | waiting
4.294 | agv2 | -1.2 | 0.0 | 0.0 | waiting
4.294 | agv3 | -1.2 | 0.6 | 0.0 | waiting
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
