taimecha/da_robot_kho_hang/docs/warehouse_continuous30_validation/trajectories.csv

t_s | robot | x_m | y_m | yaw_rad | phase | payload
0.231 | agv1 | -1.2 | -0.6 | 0.0 | waiting
0.231 | agv2 | -1.2 | 0.0 | 0.0 | waiting
0.231 | agv3 | -1.2 | 0.6 | 0.0 | waiting
0.731 | agv1 | -1.2 | -0.6 | 0.0 | waiting
0.731 | agv2 | -1.2 | 0.0 | 0.0 | waiting
0.731 | agv3 | -1.2 | 0.6 | 0.0 | waiting
1.282 | agv1 | -1.2 | -0.6 | 0.0 | waiting
1.282 | agv2 | -1.2 | 0.0 | 0.0 | waiting
1.282 | agv3 | -1.2 | 0.6 | 0.0 | waiting
1.831 | agv1 | -1.2 | -0.6 | 0.0 | waiting
1.831 | agv2 | -1.2 | 0.0 | 0.0 | waiting
1.831 | agv3 | -1.2 | 0.6 | 0.0 | waiting
2.331 | agv1 | -1.2 | -0.6 | 0.0 | waiting
2.331 | agv2 | -1.2 | 0.0 | 0.0 | waiting
2.331 | agv3 | -1.2 | 0.6 | 0.0 | waiting
2.881 | agv1 | -1.2 | -0.6 | 0.0 | waiting
2.881 | agv2 | -1.2 | 0.0 | 0.0 | waiting
2.881 | agv3 | -1.2 | 0.6 | 0.0 | waiting
3.382 | agv1 | -1.2 | -0.6 | 0.0 | waiting
3.382 | agv2 | -1.2 | 0.0 | 0.0 | waiting
3.382 | agv3 | -1.2 | 0.6 | 0.0 | waiting
3.931 | agv1 | -1.2 | -0.6 | 0.0 | waiting
3.931 | agv2 | -1.2 | 0.0 | 0.0 | waiting
3.931 | agv3 | -1.2 | 0.6 | 0.0 | waiting
4.431 | agv1 | -1.2 | -0.6 | 0.0 | waiting
4.431 | agv2 | -1.2 | 0.0 | 0.0 | waiting
4.431 | agv3 | -1.2 | 0.6 | 0.0 | waiting
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
