taimecha/da_robot_kho_hang/docs/warehouse_sim_validation/trajectories.csv

t_s | robot | x_m | y_m | yaw_rad | phase | payload
2.304 | agv1 | -1.2 | -0.6 | 0.0 | waiting
2.304 | agv2 | -1.2 | 0.0 | 0.0 | waiting
2.304 | agv3 | -1.2 | 0.6 | 0.0 | waiting
2.853 | agv1 | -1.2 | -0.6 | 0.0 | waiting
2.853 | agv2 | -1.2 | 0.0 | 0.0 | waiting
2.853 | agv3 | -1.2 | 0.6 | 0.0 | waiting
3.403 | agv1 | -1.2 | -0.6 | 0.0 | waiting
3.403 | agv2 | -1.2 | 0.0 | 0.0 | waiting
3.403 | agv3 | -1.2 | 0.6 | 0.0 | waiting
3.953 | agv1 | -1.2 | -0.6 | 0.0 | waiting
3.953 | agv2 | -1.2 | 0.0 | 0.0 | waiting
3.953 | agv3 | -1.2 | 0.6 | 0.0 | waiting
4.453 | agv1 | -1.2 | -0.6 | 0.0 | waiting
4.453 | agv2 | -1.2 | 0.0 | 0.0 | waiting
4.453 | agv3 | -1.2 | 0.6 | 0.0 | waiting
5.003 | agv1 | -1.2 | -0.6 | 0.0 | waiting
5.003 | agv2 | -1.2 | 0.0 | 0.0 | waiting
5.003 | agv3 | -1.2 | 0.6 | 0.0 | waiting
5.553 | agv1 | -1.2 | -0.6 | 0.0 | waiting
5.553 | agv2 | -1.2 | 0.0 | 0.0 | waiting
5.553 | agv3 | -1.2 | 0.6 | 0.0 | waiting
6.053 | agv1 | -1.2 | -0.6 | 0.0 | waiting
6.053 | agv2 | -1.2 | 0.0 | 0.0 | waiting
6.053 | agv3 | -1.2 | 0.6 | 0.0 | waiting
6.553 | agv1 | -1.2 | -0.6 | 0.0 | waiting
6.553 | agv2 | -1.2 | 0.0 | 0.0 | waiting
6.553 | agv3 | -1.2 | 0.6 | 0.0 | waiting
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
