taimecha/da_robot_kho_hang/docs/warehouse_waiting_validation/trajectories.csv

t_s | robot | x_m | y_m | yaw_rad | phase | payload
0.074 | agv2 | -1.2 | 0.0 | 0.0 | waiting
0.074 | agv3 | -1.2 | 0.6 | 0.0 | waiting
0.624 | agv2 | -1.2 | 0.0 | 0.0 | waiting
0.624 | agv3 | -1.2 | 0.6 | 0.0 | waiting
0.624 | agv1 | -1.2 | -0.6 | 0.0 | waiting
1.174 | agv2 | -1.2 | 0.0 | 0.0 | waiting
1.174 | agv3 | -1.2 | 0.6 | 0.0 | waiting
1.174 | agv1 | -1.2 | -0.6 | 0.0 | waiting
1.674 | agv2 | -1.2 | 0.0 | 0.0 | waiting
1.674 | agv3 | -1.2 | 0.6 | 0.0 | waiting
1.674 | agv1 | -1.2 | -0.6 | 0.0 | waiting
2.224 | agv2 | -1.2 | 0.0 | 0.0 | waiting
2.224 | agv3 | -1.2 | 0.6 | 0.0 | waiting
2.224 | agv1 | -1.2 | -0.6 | 0.0 | waiting
2.774 | agv2 | -1.2 | 0.0 | 0.0 | waiting
2.774 | agv3 | -1.2 | 0.6 | 0.0 | waiting
2.774 | agv1 | -1.2 | -0.6 | 0.0 | waiting
3.274 | agv2 | -1.2 | 0.0 | 0.0 | waiting
3.274 | agv3 | -1.2 | 0.6 | 0.0 | waiting
3.274 | agv1 | -1.2 | -0.6 | 0.0 | waiting
3.774 | agv2 | -1.2 | 0.0 | 0.0 | waiting
3.774 | agv3 | -1.2 | 0.6 | 0.0 | waiting
3.774 | agv1 | -1.2 | -0.6 | 0.0 | waiting
4.324 | agv2 | -1.2 | 0.0 | 0.0 | waiting
4.324 | agv3 | -1.2 | 0.6 | 0.0 | waiting
4.324 | agv1 | -1.2 | -0.6 | 0.0 | waiting
4.824 | agv2 | -1.2 | 0.0 | 0.0 | waiting
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
