taimecha/da_robot_kho_hang/docs/warehouse_column_validation/flexible30/trajectories.csv

t_s | robot | x_m | y_m | yaw_rad | phase | payload
0.073 | agv2 | -1.2 | 0.0 | 0.0 | waiting
0.668 | agv2 | -1.2 | 0.0 | 0.0 | waiting
0.668 | agv1 | -1.2 | -0.6 | 0.0 | waiting
0.668 | agv3 | -1.2 | 0.6 | 0.0 | waiting
1.175 | agv2 | -1.2 | 0.0 | 0.0 | waiting
1.175 | agv1 | -1.2 | -0.6 | 0.0 | waiting
1.175 | agv3 | -1.2 | 0.6 | 0.0 | waiting
1.723 | agv2 | -1.2 | 0.0 | 0.0 | waiting
1.723 | agv1 | -1.2 | -0.6 | 0.0 | waiting
1.723 | agv3 | -1.2 | 0.6 | 0.0 | waiting
2.273 | agv2 | -1.2 | 0.0 | 0.0 | waiting
2.273 | agv1 | -1.2 | -0.6 | 0.0 | waiting
2.273 | agv3 | -1.2 | 0.6 | 0.0 | waiting
2.823 | agv2 | -1.2 | 0.0 | 0.0 | waiting
2.823 | agv1 | -1.2 | -0.6 | 0.0 | waiting
2.823 | agv3 | -1.2 | 0.6 | 0.0 | waiting
3.373 | agv2 | -1.2 | 0.0 | 0.0 | waiting
3.373 | agv1 | -1.2 | -0.6 | 0.0 | waiting
3.373 | agv3 | -1.2 | 0.6 | 0.0 | waiting
3.873 | agv2 | -1.2 | 0.0 | 0.0 | waiting
3.873 | agv1 | -1.2 | -0.6 | 0.0 | waiting
3.873 | agv3 | -1.2 | 0.6 | 0.0 | waiting
4.373 | agv2 | -1.2 | 0.0 | 0.0 | waiting
4.373 | agv1 | -1.2 | -0.6 | 0.0 | waiting
4.373 | agv3 | -1.2 | 0.6 | 0.0 | waiting
4.923 | agv2 | -1.2 | 0.0 | 0.0 | waiting
4.923 | agv1 | -1.2 | -0.6 | 0.0 | waiting
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
