taimecha/da_robot_kho_hang/data/sim_trial_01_20261026/measurements.csv

car | box_id | width_true_cm | height_true_cm | width_measured_cm | height_measured_cm | width_error_cm | height_error_cm | delivery_row | delivery_col | final_position_error_cm | T_total_s
agv1 | 2 | 18.5 | 32.0 | 18.7742 | 32.4647 | 0.2742 | 0.4647 | 1 | 2 | 0.6419 | 78.603
agv2 | 1 | 12.1 | 24.0 | 12.3376 | 24.4088 | 0.2376 | 0.4088 | 1 | 1 | 0.6943 | 93.46
