taimecha/da_robot_kho_hang/docs/warehouse_column_validation/six_gui/trajectories.csv

t_s | robot | x_m | y_m | yaw_rad | phase | payload
0.28 | agv1 | -1.2 | -0.6 | 0.0 | waiting
0.28 | agv2 | -1.2 | 0.0 | 0.0 | waiting
0.28 | agv3 | -1.2 | 0.6 | 0.0 | waiting
0.83 | agv1 | -1.2 | -0.6 | 0.0 | waiting
0.83 | agv2 | -1.2 | 0.0 | 0.0 | waiting
0.83 | agv3 | -1.2 | 0.6 | 0.0 | waiting
1.33 | agv1 | -1.2 | -0.6 | 0.0 | waiting
1.33 | agv2 | -1.2 | 0.0 | 0.0 | waiting
1.33 | agv3 | -1.2 | 0.6 | 0.0 | waiting
1.83 | agv1 | -1.2 | -0.6 | 0.0 | waiting
1.83 | agv2 | -1.2 | 0.0 | 0.0 | waiting
1.83 | agv3 | -1.2 | 0.6 | 0.0 | waiting
2.38 | agv1 | -1.2 | -0.6 | 0.0 | waiting
2.38 | agv2 | -1.2 | 0.0 | 0.0 | waiting
2.38 | agv3 | -1.2 | 0.6 | 0.0 | waiting
2.93 | agv1 | -1.2 | -0.6 | 0.0 | waiting
2.93 | agv2 | -1.2 | 0.0 | 0.0 | waiting
2.93 | agv3 | -1.2 | 0.6 | 0.0 | waiting
3.43 | agv1 | -1.2 | -0.6 | 0.0 | waiting
3.43 | agv2 | -1.2 | 0.0 | 0.0 | waiting
3.43 | agv3 | -1.2 | 0.6 | 0.0 | waiting
3.98 | agv1 | -1.2 | -0.6 | 0.0 | waiting
3.98 | agv2 | -1.2 | 0.0 | 0.0 | waiting
3.98 | agv3 | -1.2 | 0.6 | 0.0 | waiting
4.48 | agv1 | -1.2 | -0.6 | 0.0 | waiting
4.48 | agv2 | -1.2 | 0.0 | 0.0 | waiting
4.48 | agv3 | -1.2 | 0.6 | 0.0 | waiting
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
