taimecha/da_robot_kho_hang/data/warehouse_demo_20261027_104104/agv1_box_2_measured.png

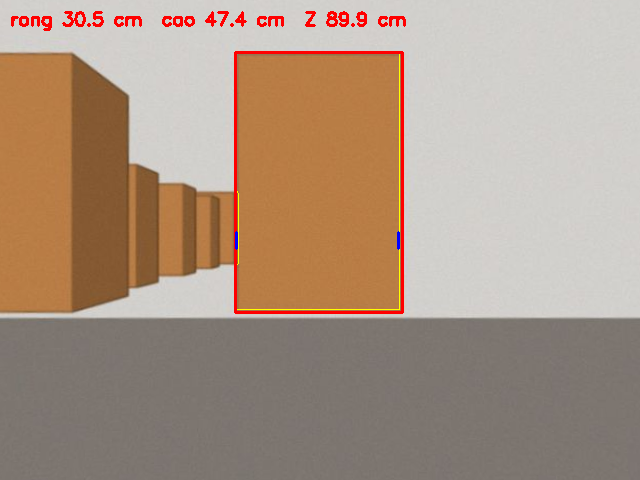
data/warehouse_demo_20261027_104104/agv1_box_2_measured.png
