taimecha/da_robot_kho_hang/data/warehouse_demo_20261027_104104/agv2_box_1_measured.png

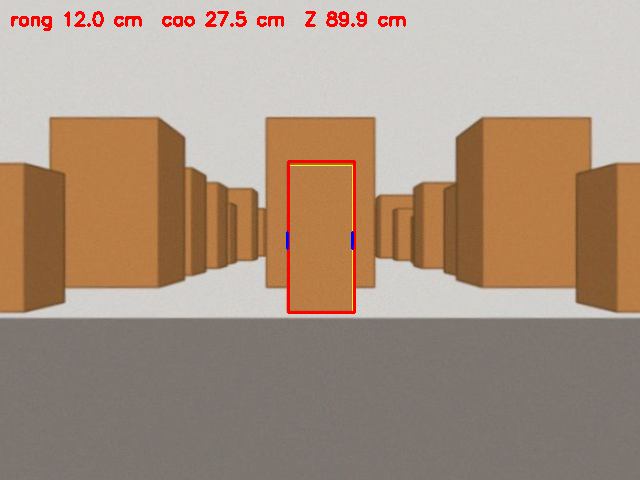
data/warehouse_demo_20261027_104104/agv2_box_1_measured.png
