taimecha/da_robot_kho_hang/data/warehouse_demo_20261027_105246/agv2_box_6_measured.png

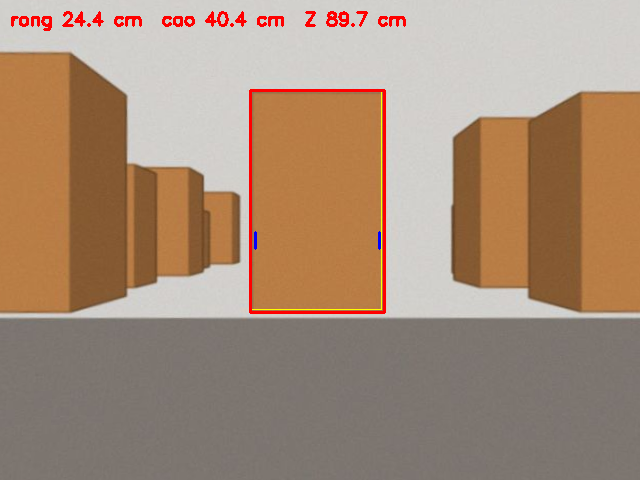
data/warehouse_demo_20261027_105246/agv2_box_6_measured.png
