taimecha/da_robot_kho_hang/docs/warehouse_column_validation/six_gui/trajectories_and_deliveries.png

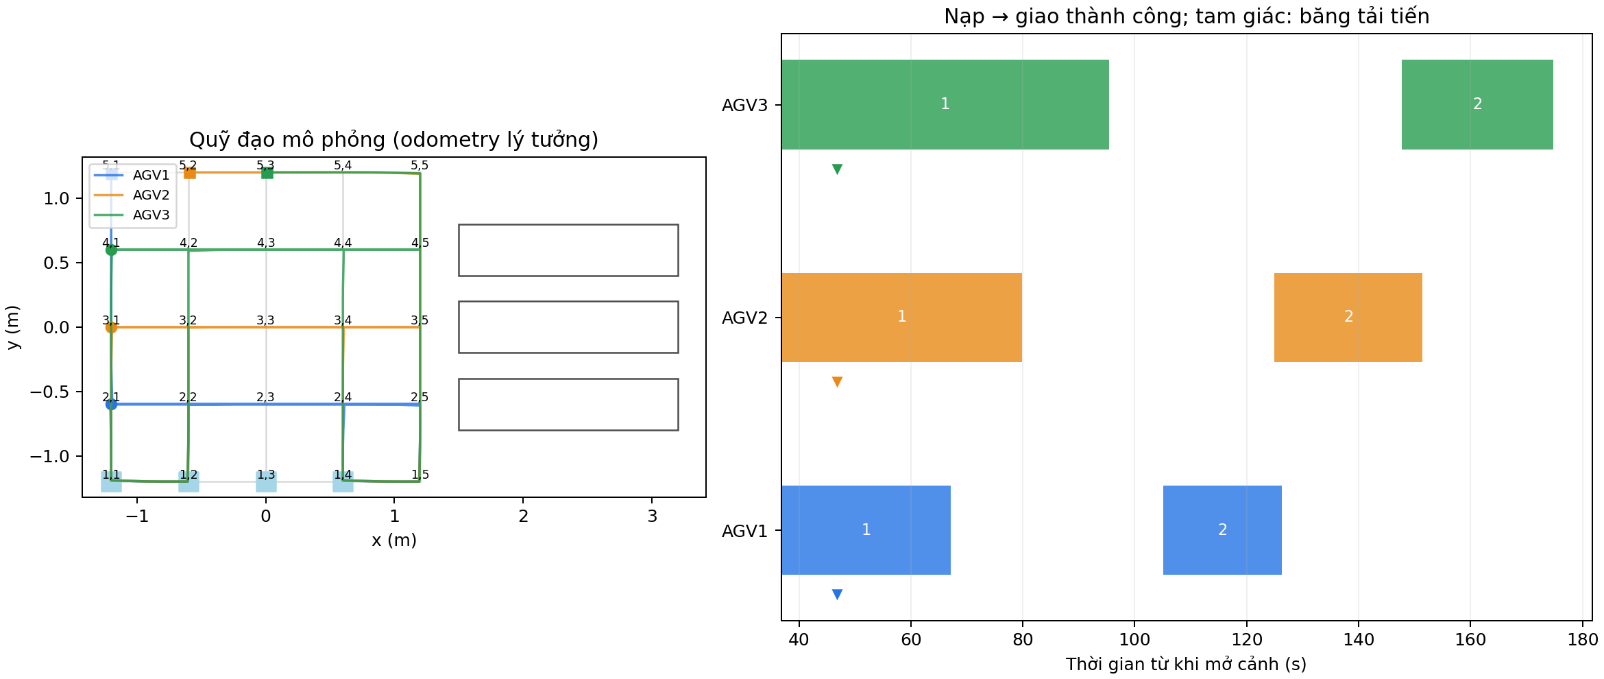
docs/warehouse_column_validation/six_gui/trajectories_and_deliveries.png
