taimecha/da_robot_kho_hang/docs/warehouse_continuous30_validation/synthetic_measurement_errors.png

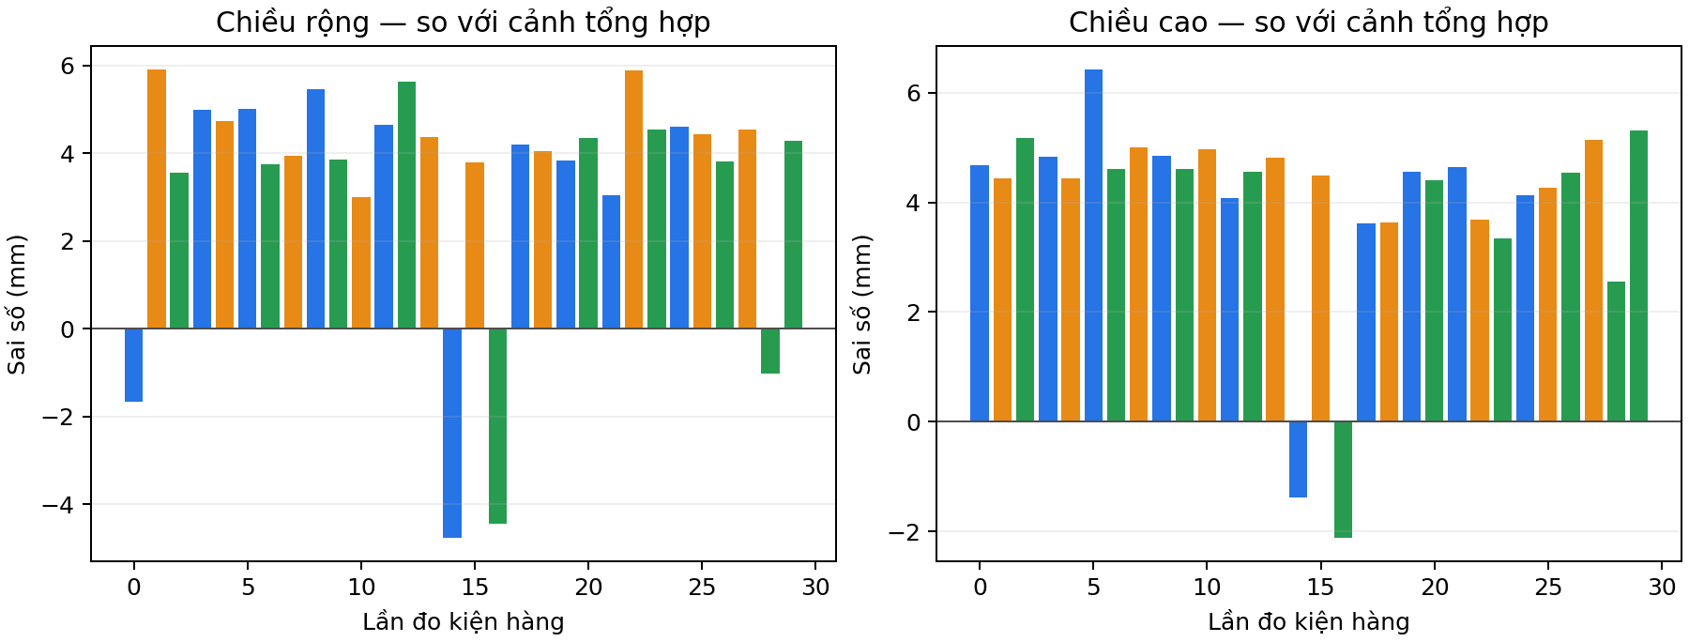
docs/warehouse_continuous30_validation/synthetic_measurement_errors.png
