taimecha/da_robot_kho_hang/docs/warehouse_factory_validation/trajectories_and_deliveries.png

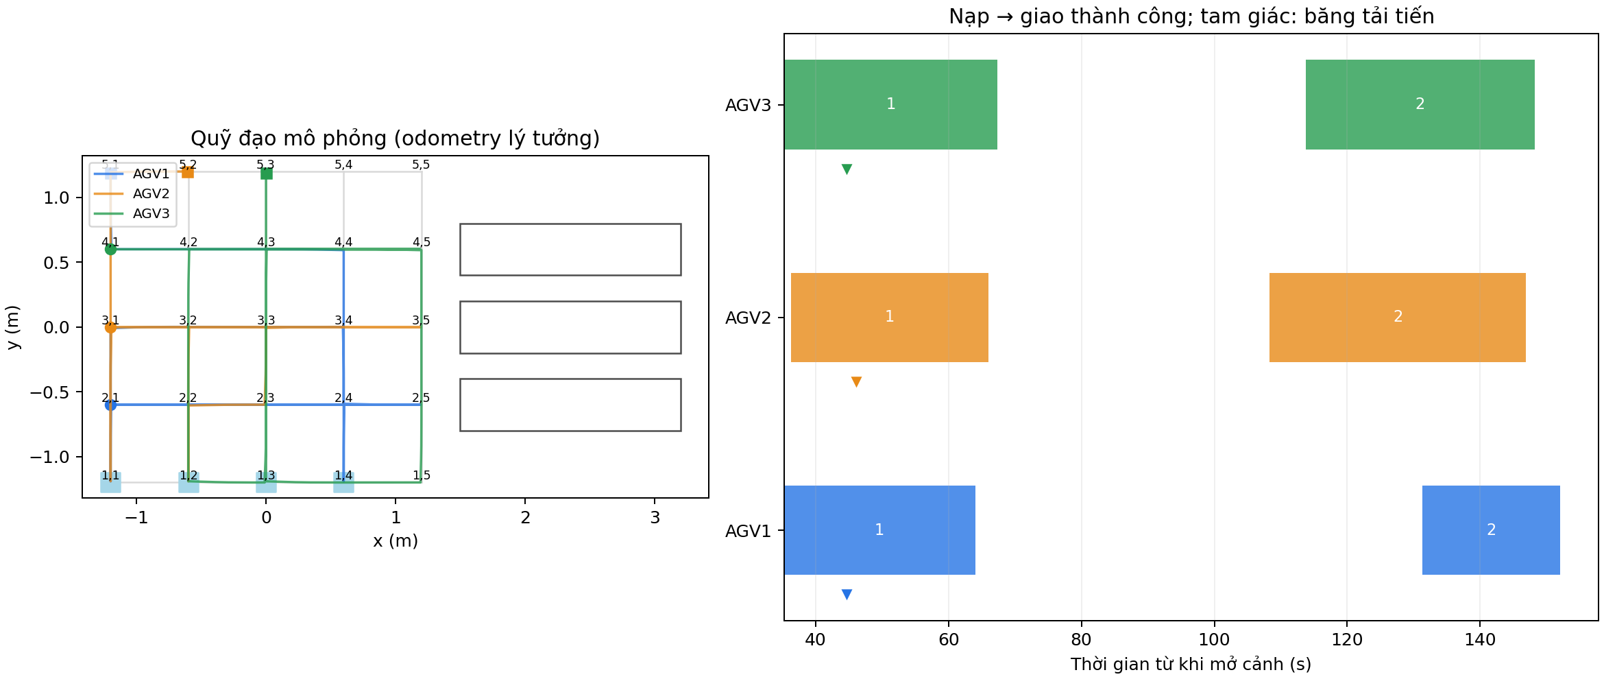
docs/warehouse_factory_validation/trajectories_and_deliveries.png
