taimecha/da_robot_kho_hang/docs/figures/pid_real_agv1/agv1_drive_2m_20261018_201712.pdf

30

40

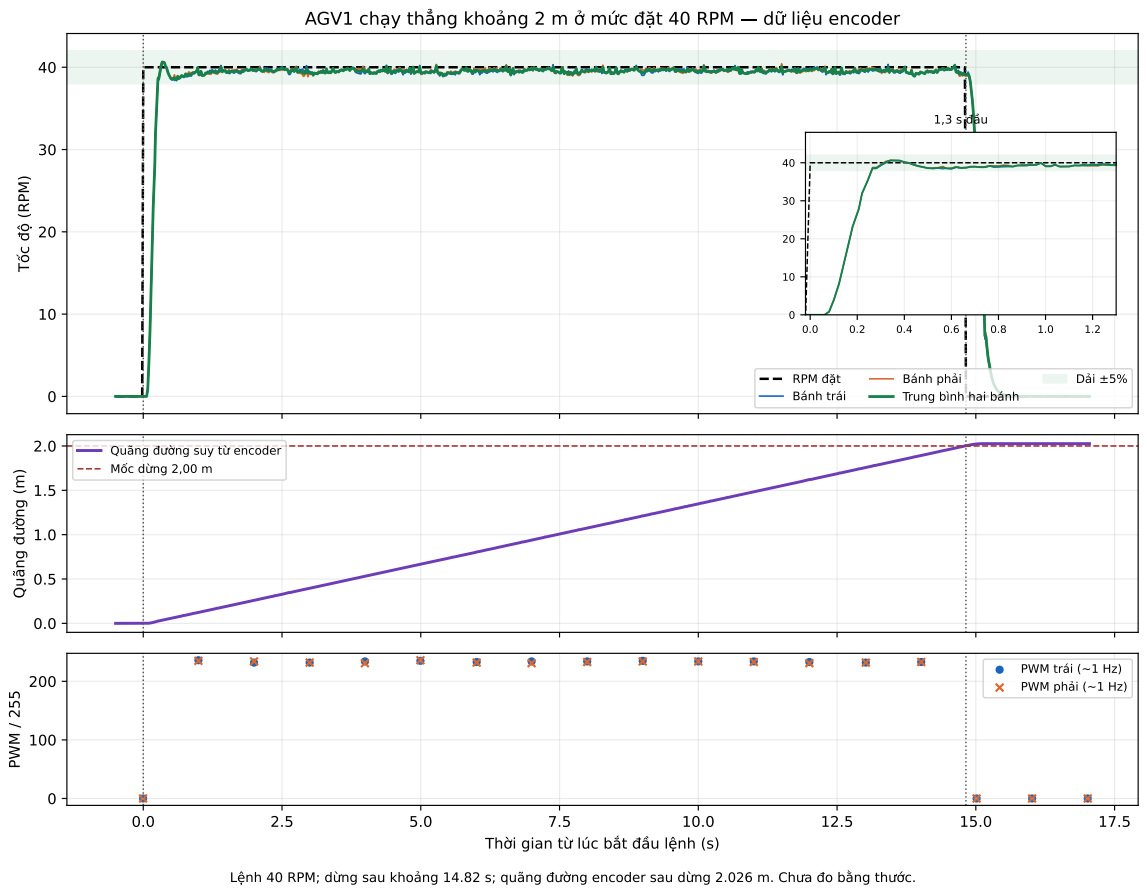
[picture p136: page 1]
T c (RPM); AGV1 ch y th ng kho ng 2 m; t 40 RPM; d li u encoder; Bánh trái; Trung bình; hai bánh; Quãng ng (m); Quãng; ng suy t encoder; Th i gian t lúc b t; PWM / 255; L nh 40 RPM; d ng sau kho ng 14.82 s; quãng; ng encoder sau d ng 2.026 m. Ch a o b ng th

0.0 RPM | 0.2 0.4 0.6 Bánh ph i t | 0.8 1.0 1.2 D i ±5%

PWM trái (~1 Hz)
PWM ph i (~1 Hz)
