taimecha/da_robot_kho_hang/docs/figures/pid_real_agv1/agv1_pid_20261018_194245.pdf

AGV1 | áp ng i u khi n t c | hai bánh trên sàn

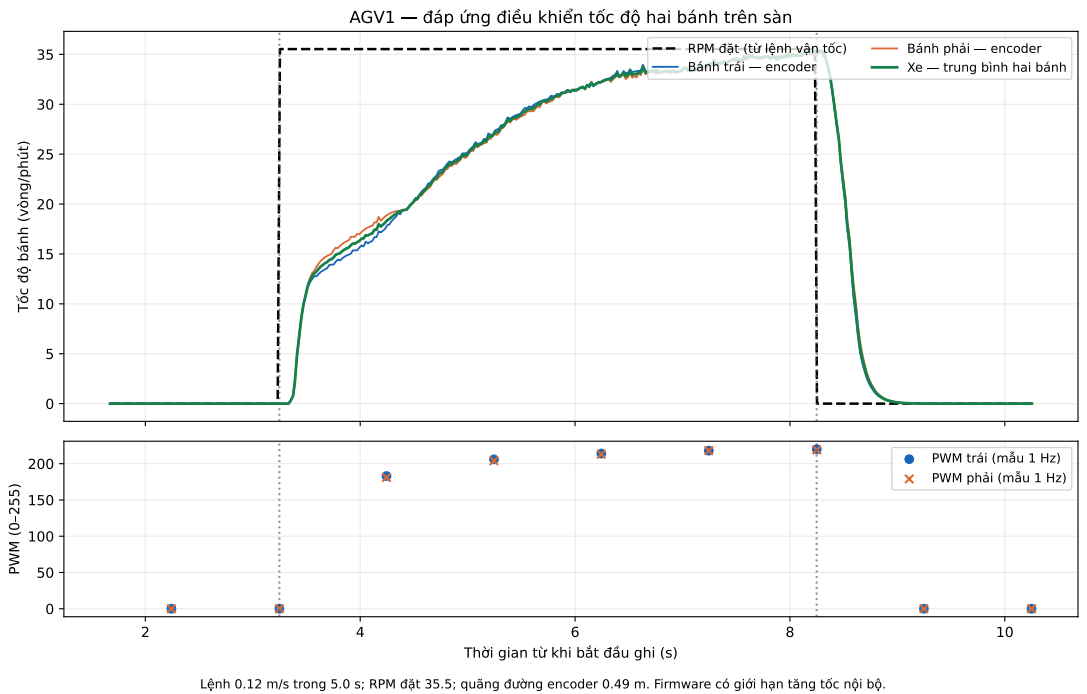
[picture p137: page 1]
Th i gian t khi b t; u ghi (s); PWM (0 255); L nh 0.12 m/s trong 5.0 s; RPM; t 35.5; quãng; ng encoder 0.49 m. Firmware có gi i h n t ng t c n i b .

RPM t (t l nh v n t c) | Bánh ph i encoder
Bánh trái encoder | Xe trung bình hai bánh

T c bánh (vòng/phút)

PWM trái (m u 1 Hz)
PWM ph i (m u 1 Hz)
