taimecha/da_robot_kho_hang/docs/figures/pid_real_agv1/agv1_pid_20261018_195832.pdf

AGV1 | áp ng i u khi n t c | hai bánh trên sàn

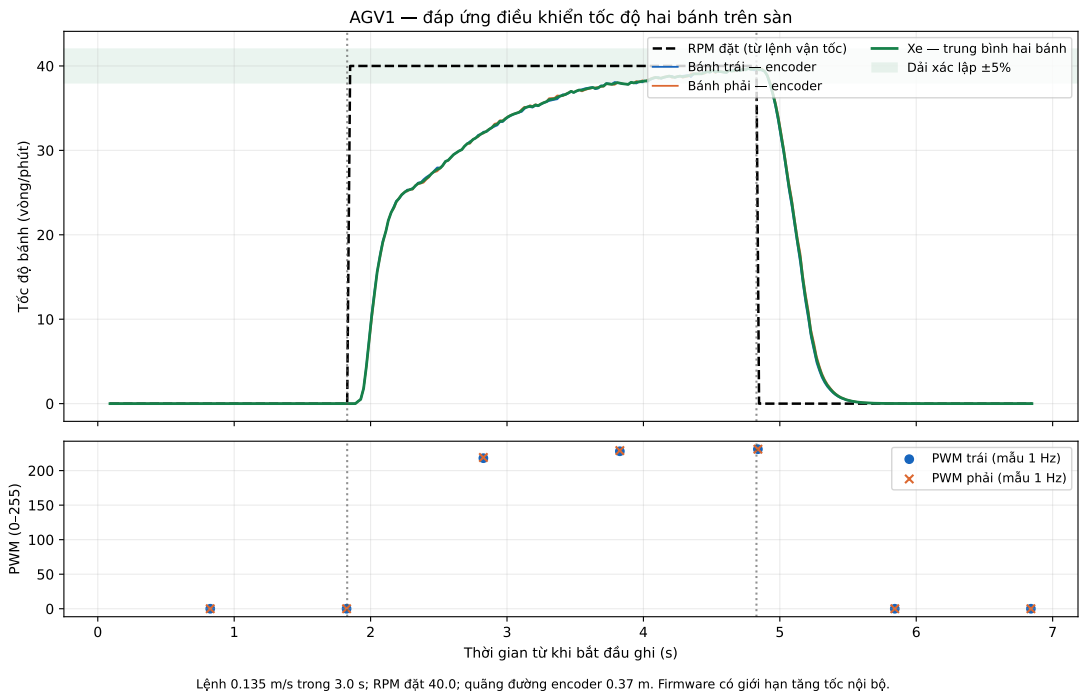
[picture p138: page 1]
Bánh trái; encoder; Th i gian t khi b t; u ghi (s); PWM (0 255); L nh 0.135 m/s trong 3.0 s; RPM; t 40.0; quãng; ng encoder 0.37 m. Firmware có gi i h n t ng t c n i b .

RPM t (t | l nh v n t c) | Xe D | trung bình hai bánh i xác l p ±5%

Bánh ph i | encoder

T c bánh (vòng/phút)

PWM trái (m u 1 Hz)
PWM ph i (m u 1 Hz)
