taimecha/da_robot_kho_hang/docs/figures/pid_real_agv1/agv1_pid_20261018_201115.pdf

AGV1 | áp ng i u khi n t c | hai bánh trên giá kê

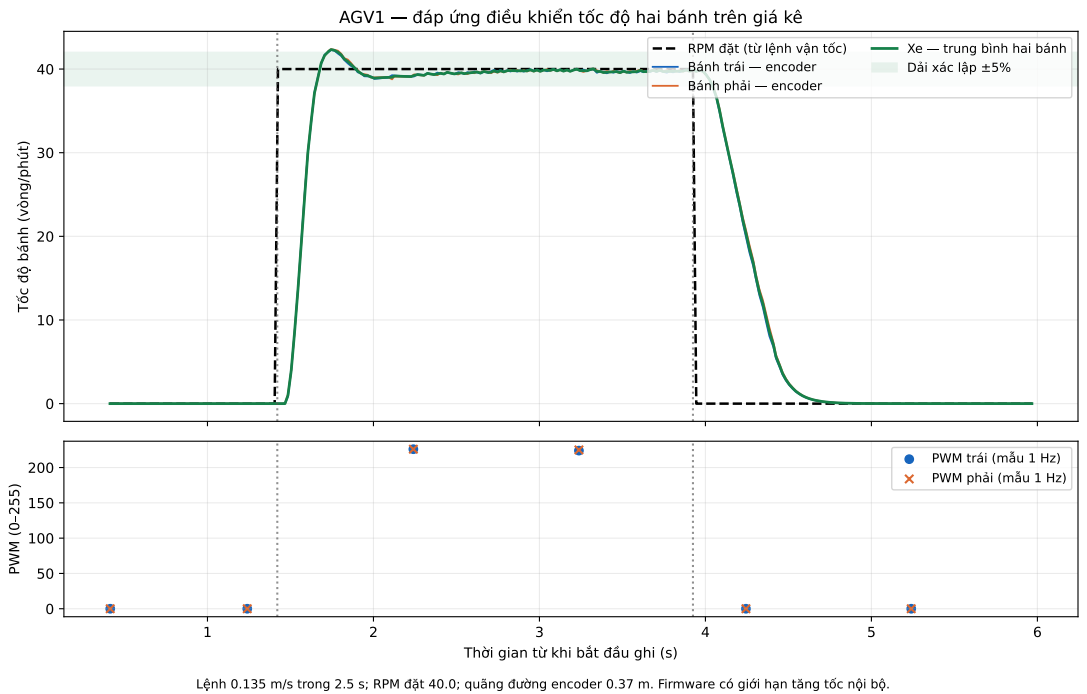
[picture p140: page 1]
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

RPM Bánh trái | t (t l nh v n t c) encoder | Xe trung bình hai bánh D i xác l p ±5%

Bánh ph i | encoder

T c bánh (vòng/phút)

PWM trái (m u 1 | Hz)
PWM ph i (m u 1 Hz)
