taimecha/da_robot_kho_hang/(commit log)

2026-10-15 feat: ổn định điều hướng và chốt đo hộp cho hai xe thật
2026-10-16 feat: prepare continuous AGV research demos and delivery evidence
    [robot.urdf.xacro]
2026-10-18 feat: record AGV1 PID tuning and research evidence
    [agv1_drive_2m_20261018_201712_diag.csv, agv1_drive_2m_20261018_201712_joint.csv, agv1_pid_20261018_194245_diag.csv, agv1_pid_20261018_194245_joint.csv, agv1_pid_20261018_194245_summary.json, agv1_pid_20261018_195417_diag.csv, agv1_pid_20261018_195417_joint.csv, agv1_pid_20261018_195417_summary.json]
2026-10-18 feat: apply tested wheel speed gains to AGV2
2026-10-24 fix: stabilize real AGV navigation and cargo measurement
    Restore micro-ROS MTU compatibility, add single-pass heading control and bounded goal alignment, preserve delivery approach headings, and improve five-frame camera measurement with real validation notes and regression tests.
    [esp32_agv_base.ino]
2026-10-24 feat: add three-AGV warehouse simulation and validation
    [serial_trajectories.csv, staged_trajectories.csv, trajectories.csv]
2026-10-26 feat: add verified two-AGV trials and report handoff
    Update real AGV LiDAR decoding, localization and cargo recovery; retain current warehouse simulation improvements. Archive real and two-box simulated trials with CSV results, screenshots, split MCAP recordings, checksums and source snapshots. Add an evidence-based report editing guide and update experiment commands. Validation: 188 Python tests passed; archived payloads and timestamps verified against original rosbag recordings.
    [attempt4_cargo_times.csv, cargo_times.csv, cargo_times_latest.csv, comparison_real_sim.csv, measurements.csv]
2026-10-28 feat: publish updated report, demo videos and simulation runs
    [agv1.urdf, agv2.urdf, agv3.urdf, trajectories.csv, warehouse.sdf]
